rachitpatel019/riscv-cpu/8_stage_pipeline/docs/architecture.html

# 8-Stage Pipelined RISC-V (RV32I) CPU - Architecture Specification

Rendered Web Version: https://htmlpreview.github.io/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
ISA: RISC-V RV32I (Base Integer Instruction Set)
Data Width: 32-bit
Pipeline Depth: 8 stages
Memory: Harvard architecture (separate instruction and data memories)
FPGA Target: Intel/Altera (M9K BRAM inference)
Features: Data forwarding, hazard detection with stalling, branch target early calculation (Stage 4), Branch History Table (BHT) dynamic prediction, branch/jump resolution, MMIO peripherals
Top Module: core

### Table of Contents

1. Architecture Overview
  - Signal Naming Conventions
2. Pipeline Diagram
  - Pipeline Timing Diagram
  - Top-Level Datapath and Diagrams
3. Packages
  - Full ISA Instruction Tables
4. Stage 1 - Fetch (F)
5. Stage 2 - Instruction Memory (IM)
6. Stage 3 - Decode (D)
7. Stage 4 - Register Read (RR)
  - Register File Organization & Replicated BRAMs
8. Stage 5 - Execute 1 (EX1)
9. Stage 6 - Execute 2 (EX2)
10. Stage 7 - Execute 3 / Memory (EX3/MEM)
11. Stage 8 - Writeback (WB)
12. Hazard Detection and Stalling
  - Hazard Detection Flowchart
13. Data Forwarding
14. Branch and Jump Handling
15. Branch History Table (BHT)
  - Branch Predictor State Diagram
16. Memory System
17. Memory-Mapped I/O (MMIO)
18. Pipeline Register Summary
19. Control Signal Reference
20. Module Hierarchy
  - Module Dependency Graph
21. Timing and Performance
22. Corner Cases and Assumptions
23. Glossary of FPGA Terminology

## 1. Architecture Overview

This is an 8-stage pipelined RISC-V processor implementing the RV32I base integer instruction set. The pipeline splits a classic 5-stage design into 8 stages to improve clock frequency on FPGA targets by reducing the critical path length per stage. The stages are:

1. Fetch (F) - PC generation and update; PC redirected by Stage 4 branch prediction or Stage 7 branch/jump resolution
2. Instruction Memory (IM) - Synchronous instruction memory read (1-cycle latency)
3. Decode (D) - Instruction decoding, control signal generation, immediate extraction, and BHT read index generation
4. Register Read (RR) - Register file read (synchronous, 1-cycle latency), forwarding decision, early branch target address calculation (PC + imm), and BHT branch prediction evaluation
5. Execute 1 (EX1) - Operand selection with forwarding muxes
6. Execute 2 (EX2) - ALU computation, branch condition evaluation
7. Execute 3 / Memory (EX3/MEM) - PC target finalization, BHT update, memory read/write initiation
8. Writeback (WB) - Writeback data selection and register file write

The processor uses a Harvard memory architecture with separate instruction and data memories. Both memories are synchronous (M9K BRAM-based), introducing one-cycle read latency each. Data hazards are resolved through a combination of stalling (hazard detection unit) and data forwarding (forwarding unit). Branch target addresses are computed early in Stage 4 (RR) using the decoded PC and immediate, eliminating the one-cycle adder from Stage 6's critical path. A Branch History Table (BHT) provides dynamic taken/not-taken prediction. The BHT is queried in Decode (Stage 3) and evaluated in Register Read (Stage 4). When a branch is predicted taken, it redirects the PC from Stage 4 (RR), reducing the taken-branch penalty from 6 cycles to 3 cycles when the prediction is correct. Unconditional JAL jumps are also resolved early in Stage 4 (RR), incurring a 3-cycle flush penalty. Final branch and JALR jump resolution occurs in Stage 7 (EX3/MEM); a branch misprediction or JALR jump incurs a 6-cycle flush penalty.

### 1.1 Signal Naming Conventions

The codebase employs strict signal naming prefixes to reflect the pipeline stage in which a signal originates or is consumed. This prevents synthesis errors and makes tracing cross-stage paths straightforward.

Prefix | Pipeline Stage | Description / Examples
F_ | Fetch (Stage 1) | Signals active in the Instruction Fetch stage. e.g., F_pc
IM_ | IMEM Read (Stage 2) | Signals active in the Instruction Memory read stage. e.g., IM_instruction
D_ | Decode (Stage 3) | Signals decoded from the instruction. e.g., D_rs1, D_alu_op
IDRR_ / RR_ | Register Read (Stage 4) | Signals related to register read and early branch target evaluation. e.g., IDRR_rs1_data, RR_branch_target
E1_ / EX1_ | Execute 1 (Stage 5) | Signals active during operand selection and forwarding. e.g., E1_operand_a
E2_ / EX2_ | Execute 2 (Stage 6) | Signals active during ALU calculation and branch evaluation. e.g., E2_alu_result
E3_ / EX3_ / MEM_ | EX3 / Memory (Stage 7) | Signals active during memory routing and final PC resolution. e.g., E3_pc_target, E3_pc_sel
W_ / WB_ | Writeback (Stage 8) | Signals written to the register file. e.g., W_write_data, W_reg_write

## 2. Pipeline Diagram

stall_frontend flush (stage4_flush / E3_pc_sel) | | +--------+ +--------+ +--------+ +--------+ +--------+ +--------+ +--------+ +--------+ | Stage 1| | Stage 2| | Stage 3| | Stage 4| | Stage 5| | Stage 6| | Stage 7| | Stage 8| | FETCH |->| IMEM |->| DECODE |->|REG READ|->| EX1 |->| EX2 |->|EX3/MEM |->| WB | | | | | | | | | | | | | | | | | |pc_update| |instr_mem| |IF_ID | |regfile | |data_sel| |alu | |pc_tgt | |write- | | | | | |decode | |fwd_unit| | | |br_eval | |memory | |back | | | | | |imm_gen | |br_tgt | | | |(cond) | |MEM_WB | | | | | | | |control | |ID_RR | | | | | |bht_upd | | | | | | | |bht_read| |bht_pred| | | | | | | | | | | | | | | |RR_EX1 | |EX1_EX2 | |EX2_EX3 | | | | | +--------+ +--------+ +--------+ +--------+ +--------+ +--------+ +--------+ +--------+ |<---------- bht_counter ----------------------+ | | +<------------------------------------------- stage4_pc_sel (from RR) -+ |<---------------------------------------------------------------------+| | E3_pc_sel, E3_pc_target (from Stage 7 JALR / Misprediction) | bht_update (branch, outcome, PC) from Stage 7 to BHT (Stage 4) | | Forwarding Paths: | E2_fwd_val (EX2 -> EX1 data_sel) = (wb_sel==10) ? PC+4 : alu_result | E3_fwd_val (EX3 -> EX1 data_sel) = (wb_sel==10) ? PC+4 : alu_result | W_fwd_val (WB -> EX1 data_sel) = W_write_data | +<------------------------------- W_rd, W_write_data, W_reg_write -------------------+ (Register File Write Port) Hazard Detection Unit: Inputs from: D (rs1, rs2, uses_rs1, uses_rs2), RR (rd, reg_write), E1 (rd, reg_write) Output: stall_frontend -> stalls Stages 1-3, inserts bubble at ID_RR boundary Branch Target Calculation (Stage 4 - RR): branch_target = RR_pc + RR_imm (combinational adder in core.sv) Pipelined through RR_EX1 and EX1_EX2; used by pc_target_calc in Stage 7 and early JAL in Stage 4.

### 2.2 Pipeline Timing Diagram

The following table illustrates the progression of consecutive instructions through all 8 stages of the pipeline over sequential clock cycles.

Instruction | Cycle 1 | Cycle 2 | Cycle 3 | Cycle 4 | Cycle 5 | Cycle 6 | Cycle 7 | Cycle 8 | Cycle 9 | Cycle 10
Inst 1: ADD x1, x2, x3 | F | IM | D | RR | E1 | E2 | E3 | WB
Inst 2: SUB x4, x5, x6 | | F | IM | D | RR | E1 | E2 | E3 | WB
Inst 3: LW x7, 0(x1) | | | F | IM | D | RR | E1 | E2 | E3 | WB
Inst 4: OR x8, x7, x9 (RAW Stall) | | | | F | IM | D | STALL | RR | E1 | E2

## 2.5 Top-Level Datapath and Diagrams

This section contains the block diagrams of the CPU architecture and the detailed datapath interconnects.

### 2.5.1 Top-Level Block Diagram

The diagram below shows the high-level progression of instruction flow and the primary control links.

graph LR F[Stage 1: Fetch] --> IM[Stage 2: IMEM Read] IM --> D[Stage 3: Decode] D --> RR[Stage 4: Reg Read] RR --> E1[Stage 5: Execute 1] E1 --> E2[Stage 6: Execute 2] E2 --> E3[Stage 7: EX3/MEM] E3 --> WB[Stage 8: Writeback] WB -.->|Register Writeback| RR E3 -.->|Branch/Jump Redirect| F RR -.->|Predict Taken Redirect| F

### 2.5.2 Datapath Diagram

A detailed view of the functional units and stage boundaries, highlighting the control signals, multiplexers, and hardware blocks.

graph TD subgraph ST1 [Stage 1: Fetch] PC[PC Register] --> IMEM_ADDR[Instruction Memory Address] end subgraph ST2 [Stage 2: IMEM] IMEM[Instruction Memory] --> INSTR[Instruction Latch] end subgraph ST3 [Stage 3: Decode] DEC[Decode Logic] --> RS1_ADDR[rs1] DEC --> RS2_ADDR[rs2] DEC --> IMM[Immediate Generator] DEC --> CTRL[Control Unit] end subgraph ST4 [Stage 4: Reg Read] RF[Register File Replicated BRAMs] BHT[Branch History Table] ADD_TGT[Early Target Adder: PC + Imm] end subgraph ST5 [Stage 5: EX1] MUX_A[Operand A Mux] MUX_B[Operand B Mux] end subgraph ST6 [Stage 6: EX2] ALU[ALU Unit] BEV[Branch Eval Unit] end subgraph ST7 [Stage 7: EX3/MEM] DMEM[Data Memory BRAM] MMIO[MMIO Router] PTG[PC Target Calc] end subgraph ST8 [Stage 8: WB] MUX_WB[Writeback Mux] end INSTR --> DEC RS1_ADDR & RS2_ADDR --> RF RF --> MUX_A & MUX_B MUX_A & MUX_B --> ALU ALU --> DMEM & MMIO & MUX_WB DMEM & MMIO --> MUX_WB MUX_WB -->|Writeback Data| RF HU[Hazard Detection Unit] -.->|Stall Frontend / Flush ID_RR| PC HU -.->|Stall Frontend / Flush ID_RR| INSTR FU[Forwarding Unit] -.->|EX2/EX3/WB Bypass Selects| MUX_A & MUX_B

## 3. Packages

### 3.1 alu_package (alu_pkg.sv)

Defines the ALU operation encoding as a 4-bit enumerated type alu_operations.

Operation | Encoding | Description
ALU_ADD | 4'b0000 | Addition (A + B)
ALU_SUB | 4'b0001 | Subtraction (A - B)
ALU_AND | 4'b0010 | Bitwise AND
ALU_OR | 4'b0011 | Bitwise OR
ALU_XOR | 4'b0100 | Bitwise XOR
ALU_SLTU | 4'b0101 | Set Less Than Unsigned
ALU_SLT | 4'b0110 | Set Less Than Signed
ALU_SLL | 4'b0111 | Shift Left Logical
ALU_SRL | 4'b1000 | Shift Right Logical
ALU_SRA | 4'b1001 | Shift Right Arithmetic
ALU_PASS | 4'b1010 | Pass-through B (used for LUI)

### 3.2 decoder_package (decoder_pkg.sv)

Defines opcode and function field enumerations for instruction decoding.

#### Opcodes (opcode_t, 7-bit)

Name | Encoding | Instruction Type
OP_R | 7'b0110011 | R-type (register-register ALU)
OP_I | 7'b0010011 | I-type (register-immediate ALU)
OP_I_LOAD | 7'b0000011 | I-type (loads: LB, LH, LW, LBU, LHU)
OP_S | 7'b0100011 | S-type (stores: SB, SH, SW)
OP_B | 7'b1100011 | B-type (conditional branches)
OP_U_LUI | 7'b0110111 | U-type (Load Upper Immediate)
OP_U_AUIPC | 7'b0010111 | U-type (Add Upper Immediate to PC)
OP_J | 7'b1101111 | J-type (JAL)
OP_I_JALR | 7'b1100111 | I-type (JALR)

#### funct3 for R/I-type ALU (f3_RI_t, 3-bit)

Name | Encoding | Operation
F3_ADD_SUB | 3'b000 | ADD / SUB (distinguished by funct7)
F3_SLL | 3'b001 | Shift Left Logical
F3_SLT | 3'b010 | Set Less Than
F3_SLTU | 3'b011 | Set Less Than Unsigned
F3_XOR | 3'b100 | XOR
F3_SRL_SRA | 3'b101 | SRL / SRA (distinguished by funct7)
F3_OR | 3'b110 | OR
F3_AND | 3'b111 | AND

#### funct7 for R-type (f7_R_t, 7-bit)

Name | Encoding | Usage
F7_ADD_SRL | 7'b0000000 | Selects ADD (with F3_ADD_SUB) or SRL (with F3_SRL_SRA)
F7_SUB_SRA | 7'b0100000 | Selects SUB (with F3_ADD_SUB) or SRA (with F3_SRL_SRA)

### 3.3 Full ISA Instruction Tables

The processor implements the standard 32-bit RV32I base user-level ISA. The table below lists all supported instructions, their formats, and functional descriptions.

Instruction | Type | Opcode (7-bit) | funct3 (3-bit) | funct7 (7-bit) | Description
ADD rd, rs1, rs2 | R | 0110011 | 000 | 0000000 | rd = rs1 + rs2
SUB rd, rs1, rs2 | R | 0110011 | 000 | 0100000 | rd = rs1 - rs2
SLL rd, rs1, rs2 | R | 0110011 | 001 | 0000000 | rd = rs1 << rs2[4:0] (logical)
SLT rd, rs1, rs2 | R | 0110011 | 010 | 0000000 | rd = (rs1 < rs2) ? 1 : 0 (signed)
SLTU rd, rs1, rs2 | R | 0110011 | 011 | 0000000 | rd = (rs1 < rs2) ? 1 : 0 (unsigned)
XOR rd, rs1, rs2 | R | 0110011 | 100 | 0000000 | rd = rs1 ^ rs2
SRL rd, rs1, rs2 | R | 0110011 | 101 | 0000000 | rd = rs1 >> rs2[4:0] (logical)
SRA rd, rs1, rs2 | R | 0110011 | 101 | 0100000 | rd = rs1 >> rs2[4:0] (arithmetic)
OR rd, rs1, rs2 | R | 0110011 | 110 | 0000000 | rd = rs1 | rs2
AND rd, rs1, rs2 | R | 0110011 | 111 | 0000000 | rd = rs1 & rs2
ADDI rd, rs1, imm | I | 0010011 | 000 | - | rd = rs1 + imm
SLTI rd, rs1, imm | I | 0010011 | 010 | - | rd = (rs1 < imm) ? 1 : 0 (signed)
SLTIU rd, rs1, imm | I | 0010011 | 011 | - | rd = (rs1 < imm) ? 1 : 0 (unsigned)
XORI rd, rs1, imm | I | 0010011 | 100 | - | rd = rs1 ^ imm
ORI rd, rs1, imm | I | 0010011 | 110 | - | rd = rs1 | imm
ANDI rd, rs1, imm | I | 0010011 | 111 | - | rd = rs1 & imm
SLLI rd, rs1, shamt | I | 0010011 | 001 | 0000000 | rd = rs1 << shamt
SRLI rd, rs1, shamt | I | 0010011 | 101 | 0000000 | rd = rs1 >> shamt (logical)
SRAI rd, rs1, shamt | I | 0010011 | 101 | 0100000 | rd = rs1 >> shamt (arithmetic)
LW rd, offset(rs1) | I | 0000011 | 010 | - | rd = M[rs1 + offset] (32 bits)
LH rd, offset(rs1) | I | 0000011 | 001 | - | rd = M[rs1 + offset] (16 bits, signed)
LHU rd, offset(rs1) | I | 0000011 | 101 | - | rd = M[rs1 + offset] (16 bits, unsigned)
LB rd, offset(rs1) | I | 0000011 | 000 | - | rd = M[rs1 + offset] (8 bits, signed)
LBU rd, offset(rs1) | I | 0000011 | 100 | - | rd = M[rs1 + offset] (8 bits, unsigned)
SW rs2, offset(rs1) | S | 0100011 | 010 | - | M[rs1 + offset] = rs2 (32 bits)
SH rs2, offset(rs1) | S | 0100011 | 001 | - | M[rs1 + offset] = rs2[15:0] (16 bits)
SB rs2, offset(rs1) | S | 0100011 | 000 | - | M[rs1 + offset] = rs2[7:0] (8 bits)
BEQ rs1, rs2, offset | B | 1100011 | 000 | - | if (rs1 == rs2) PC = PC + offset
BNE rs1, rs2, offset | B | 1100011 | 001 | - | if (rs1 != rs2) PC = PC + offset
BLT rs1, rs2, offset | B | 1100011 | 100 | - | if (rs1 < rs2) PC = PC + offset (signed)
BGE rs1, rs2, offset | B | 1100011 | 101 | - | if (rs1 >= rs2) PC = PC + offset (signed)
BLTU rs1, rs2, offset | B | 1100011 | 110 | - | if (rs1 < rs2) PC = PC + offset (unsigned)
BGEU rs1, rs2, offset | B | 1100011 | 111 | - | if (rs1 >= rs2) PC = PC + offset (unsigned)
LUI rd, imm | U | 0110111 | - | - | rd = imm << 12
AUIPC rd, imm | U | 0010111 | - | - | rd = PC + (imm << 12)
JAL rd, offset | J | 1101111 | - | - | rd = PC + 4; PC = PC + offset
JALR rd, offset(rs1) | I | 1100111 | 000 | - | rd = PC + 4; PC = (rs1 + offset) & ~1

## 4. Stage 1 - Fetch (F)

### Module: pc_update

File: rtl/core/1_fetch/pc_update.sv

Generates the program counter. On each rising clock edge, updates PC based on priority:

1. reset - PC resets to 32'b0
2. pc_sel (branch/jump taken) - PC loads pc_target from Stage 7
3. stall (hazard detected) - PC holds its current value
4. Default - PC increments by 4 (pc + 4)

#### Port Interface

Port | Direction | Width | Description
clk | input | 1 | System clock
reset | input | 1 | Synchronous reset
stall | input | 1 | From hazard detection unit (stall_frontend)
pc_sel | input | 1 | Branch/jump taken signal from Stage 7 (E3_pc_sel)
pc_target | input | 32 | Target PC from Stage 7 (E3_pc_target)
pc | output | 32 | Current program counter (F_pc)

## 5. Stage 2 - Instruction Memory (IM)

### Module: instr_mem

File: rtl/core/2_imem/instr_mem.sv

Synchronous instruction memory modeled as a 16384-entry ROM/RAM array, initialized from program.hex via $readmemh. Uses M9K BRAM inference on Intel/Altera FPGAs. The synchronous read introduces a 1-cycle latency, justifying a dedicated pipeline stage.

Design Rationale — Inferring BRAM for ROM and RAM Blocks
Standard FPGA logic cells (LEs) are built to implement logic gates and individual registers, not bulk memory arrays. Registering 64 KB of Instruction ROM and 64 KB of Data RAM using Logic Elements would completely exhaust the target device resources and cause severe place-and-route congestion. Instead, this design structures ROM and RAM modules to infer physical block RAM (M9K blocks). This maps memory accesses directly onto high-speed dedicated static memory blocks on the silicon, leaving general logic elements free for the CPU execution pipeline control logic.

#### Behavior

- On each clock edge (when not stalled): reads instruction_memory[pc[31:2]] into instr_reg and latches pc into pc_reg.
- A flush_reg flag is set on reset or flush, and cleared on the next non-stalled cycle.
- When flush_reg is active, the output instruction is replaced with NOP (32'h00000013, which is ADDI x0, x0, 0) and pc_out is zeroed.

#### Port Interface

Port | Direction | Width | Description
clk | input | 1 | System clock
reset | input | 1 | Synchronous reset
stall | input | 1 | Stall signal (stall_frontend)
flush | input | 1 | Flush signal (E3_pc_sel)
pc | input | 32 | Program counter from Stage 1 (F_pc)
pc_out | output | 32 | Registered PC (IM_pc_out)
instruction | output | 32 | Fetched instruction (IM_instruction)

#### Memory Parameters

Parameter | Value | Description
MEM_DEPTH | 16384 | Number of 32-bit instruction words (64 KiB)

## 6. Stage 3 - Decode (D)

Stage 3 contains the IF/ID pipeline register, the decode unit (which wraps the immediate generator and control unit), and the ID/RR pipeline register at the stage boundary.

### 6.1 Module: IF_ID (Pipeline Register)

File: rtl/core/3_decode/IF_ID.sv

Pipeline register between Stages 2 (IMEM) and 3 (Decode). Holds the instruction and PC. On reset or flush, inserts a NOP (32'h00000013) and zeros the PC. On stall, holds its current values.

#### Port Interface

Port | Direction | Width | Description
clk | input | 1 | System clock
reset | input | 1 | Synchronous reset
stall | input | 1 | Stall signal (stall_frontend)
flush | input | 1 | Flush signal (E3_pc_sel)
pc_in | input | 32 | PC from IMEM stage (IM_pc_out)
instruction_in | input | 32 | Instruction from IMEM (IM_instruction)
pc_out | output | 32 | Registered PC (D_pc)
instruction_out | output | 32 | Registered instruction (D_instruction)

### 6.2 Module: decode (Decode Unit)

File: rtl/core/3_decode/decode.sv

Top-level decode wrapper. Extracts rs1 (bits [19:15]), rs2 (bits [24:20]), and rd (bits [11:7]) from the instruction. Instantiates imm_gen and control as sub-modules. All outputs are purely combinational.

#### Port Interface

Port | Direction | Width | Description
pc | input | 32 | Program counter (D_pc)
instruction | input | 32 | 32-bit instruction (D_instruction)
immediate | output | 32 | Sign-extended immediate value
rs1 | output | 5 | Source register 1 address
rs2 | output | 5 | Source register 2 address
rd | output | 5 | Destination register address
pc_out | output | 32 | PC pass-through
uses_rs1 | output | 1 | Instruction reads rs1
uses_rs2 | output | 1 | Instruction reads rs2
alu_op | output | 4 | ALU operation select
alu_src_a | output | 1 | 0=rs1, 1=PC for ALU input A
alu_src_b | output | 1 | 0=rs2, 1=immediate for ALU input B
reg_write | output | 1 | Register write enable
mem_read | output | 1 | Memory read enable
mem_write | output | 1 | Memory write enable
mem_size | output | 2 | Memory access size: 00=byte, 01=halfword, 10=word
mem_unsigned | output | 1 | Unsigned memory load flag
wb_sel | output | 2 | Writeback source: 00=ALU, 01=memory, 10=PC+4
branch | output | 1 | Branch instruction flag
jump | output | 1 | Jump instruction flag (JAL/JALR)
branch_type | output | 3 | Branch condition type (funct3 encoding)

### 6.3 Module: imm_gen (Immediate Generator)

File: rtl/core/3_decode/imm_gen.sv

Generates sign-extended 32-bit immediate values based on the RISC-V instruction format. Selection is determined by the opcode field.

Format | Opcodes | Immediate Construction
I-type | OP_I, OP_I_LOAD, OP_I_JALR | {{20{inst[31]}}, inst[31:20]}
S-type | OP_S | {{20{inst[31]}}, inst[31:25], inst[11:7]}
B-type | OP_B | {{19{inst[31]}}, inst[31], inst[7], inst[30:25], inst[11:8], 1'b0}
U-type | OP_U_LUI, OP_U_AUIPC | {inst[31:12], 12'b0}
J-type | OP_J | {{11{inst[31]}}, inst[31], inst[19:12], inst[20], inst[30:21], 1'b0}

### 6.4 Module: control (Control Unit)

File: rtl/core/3_decode/control.sv

Decodes the instruction opcode, funct3, and funct7 fields to produce all control signals. Combinational logic only. Imports both decoder_package and alu_package.

#### Control Signal Generation by Instruction Type

Instruction | uses_rs1 | uses_rs2 | alu_src_a | alu_src_b | reg_write | mem_read | mem_write | wb_sel | branch | jump
R-type | 1 | 1 | 0 | 0 | 1 | 0 | 0 | 00 | 0 | 0
I-type ALU | 1 | 0 | 0 | 1 | 1 | 0 | 0 | 00 | 0 | 0
Load | 1 | 0 | 0 | 1 | 1 | 1 | 0 | 01 | 0 | 0
Store | 1 | 1 | 0 | 1 | 0 | 0 | 1 | 00 | 0 | 0
Branch | 1 | 1 | 0 | 0 | 0 | 0 | 0 | 00 | 1 | 0
LUI | 0 | 0 | 0 | 1 | 1 | 0 | 0 | 00 | 0 | 0
AUIPC | 0 | 0 | 1 | 1 | 1 | 0 | 0 | 00 | 0 | 0
JAL | 0 | 0 | 1 | 1 | 1 | 0 | 0 | 10 | 0 | 1
JALR | 1 | 0 | 0 | 1 | 1 | 0 | 0 | 10 | 0 | 1

Note: mem_size is assigned directly from funct3[1:0], mem_unsigned from funct3[2], and branch_type from funct3. These are valid for load, store, and branch instructions respectively; for other instruction types they are don't-care values because the corresponding enable signals (mem_read, mem_write, branch) are deasserted.

#### ALU Operation Selection

Instruction Type | ALU Operation Logic
R-type | Decoded from funct3 + funct7 to specific ALU op
I-type ALU | Decoded from funct3 (+ funct7 for shifts) to specific ALU op
Load / Store | ALU_ADD (address calculation)
Branch | ALU_SUB (BEQ/BNE), ALU_SLT (BLT/BGE), ALU_SLTU (BLTU/BGEU)
LUI | ALU_PASS (pass immediate through)
AUIPC | ALU_ADD (PC + immediate)
JAL / JALR | ALU_ADD (target address calculation)

### 6.5 Module: ID_RR (Pipeline Register)

File: rtl/core/3_decode/ID_RR.sv

Pipeline register at the Decode/Register-Read boundary. Registers all decoded data fields and control signals. On reset or flush, all outputs are zeroed (inserting a NOP bubble). On stall, holds current values.

Important: In the core instantiation, ID_RR.flush is driven by flush || stall_frontend. This means that when the frontend is stalled, the ID_RR register is flushed (bubble inserted) rather than held. This prevents a stalled instruction from being duplicated into the backend.

#### Registered Signals

Immediate (32b), rs1 (5b), rs2 (5b), rd (5b), pc (32b), uses_rs1 (1b), uses_rs2 (1b), alu_op (4b), alu_src_a (1b), alu_src_b (1b), reg_write (1b), mem_read (1b), mem_write (1b), mem_size (2b), mem_unsigned (1b), wb_sel (2b), branch (1b), jump (1b), branch_type (3b).

## 7. Stage 4 - Register Read (RR)

Stage 4 reads operands from the register file (synchronous read, 1-cycle latency), computes forwarding select signals for Stage 5, and calculates the branch target address (PC + sign-extended immediate) combinationally from the ID_RR register outputs.

Design Rationale — Why Evaluate Branches in Stage 4?
Evaluating branch predictions in Stage 4 (Register Read) instead of Stage 3 (Decode) is a key timing and penalty optimization. Reading the BHT is initiated in Stage 3, and the resulting prediction is evaluated in Stage 4 where register operands and PC-relative branch target addresses (calculated combinationally in core.sv) are first available. By redirecting the PC from Stage 4 (flushing only stages 1–3), we limit the taken-branch penalty to exactly 3 cycles while keeping the BHT read and target addition paths from bloat-timing the Stage 3 critical path.

### 7.1 Module: regfile (Register File)

File: rtl/core/4_reg_read/regfile.sv

32-entry x 32-bit register file with two synchronous read ports and one synchronous write port. To guarantee dedicated block RAM (BRAM) mapping on the FPGA target (such as Intel M9K blocks) and eliminate LUT-based soft-logic usage, the register file uses two identical replicated RAM arrays: registers_a and registers_b. Each replicated block is configured as a Simple Dual-Port (1R1W) BRAM.

Write operations update both registers_a and registers_b simultaneously to keep the BRAM states synchronized. Read port 1 (rs1) reads from registers_a, and read port 2 (rs2) reads from registers_b. Register x0 is hardwired to zero (writes to x0 are suppressed, and it always reads as zero).

Supports explicit synchronous read-during-write forwarding: if a register is written and read in the same cycle, the write data is forwarded directly to the registered read outputs on the next clock edge, avoiding read collisions within the physical BRAM cells.

### 7.1.1 Register File Organization & Replicated BRAMs

The register file must support two concurrent read ports (rs1, rs2) and one write port (rd) in a single cycle. However, physical block RAM structures on Intel FPGAs (M9K cells) are dual-ported (supporting only 1 Read/1 Write or 2 Read/2 Write under restricted configurations).

To implement 2 Read ports and 1 Write port without using inefficient register logic (LE-based flip-flops), the Register File is designed as Replicated BRAMs:

- Replication: The 32x32 register array is duplicated into two identical physical RAMs: registers_a and registers_b.
- Write Operations: When a writeback instruction commits in Stage 8, both registers_a and registers_b are written simultaneously at the same write_address with the same write_data. This keeps their contents completely identical.
- Read Operations: Read port 1 (rs1) reads from registers_a, and Read port 2 (rs2) reads from registers_b. Since they access independent RAM blocks, both reads execute simultaneously in a single cycle.
- Collision Handling: Read-during-write conflicts (accessing a register being written in the same clock cycle) are resolved by local forwarding logic inside the regfile module. If the read index matches the write index, the write data is returned directly instead of waiting for the internal BRAM array update.

#### Port Interface

Port | Direction | Width | Description
clk | input | 1 | System clock
read_address1 | input | 5 | Read port 1 address (IDRR_rs1)
read_address2 | input | 5 | Read port 2 address (IDRR_rs2)
read_data1 | output | 32 | Read port 1 data (E1_rs1_data)
read_data2 | output | 32 | Read port 2 data (E1_rs2_data)
write_address | input | 5 | Write port address (W_rd)
write_data | input | 32 | Write port data (W_write_data)
write_enable | input | 1 | Write enable (W_reg_write)

Note: The register file uses synchronous reads (clocked), which means the read data appears one cycle after the address is presented. This is why the register file read occupies its own pipeline stage (Stage 4). The read addresses come from the ID_RR register (end of Stage 3), and the read data emerges at the input to Stage 5 (EX1), preserving the 8-stage pipeline.

### 7.2 Module: forwarding_unit

File: rtl/core/hazard_control/forwarding_unit.sv

Computed in Stage 4 (using ID_RR outputs) but the select signals are consumed in Stage 5 (via RR_EX1 register). See Section 13: Data Forwarding for full details.

### 7.3 Module: branch_predictor (Branch Predictor & Target Calculation)

File: rtl/core/4_reg_read/branch_predictor.sv

Encapsulates dynamic branch prediction and early branch target address calculation in Stage 4 (Register Read). The module instantiates the 1024-entry bht block RAM internally and provides:

- Early Branch Target Calculation: Combinationally adds PC and immediate (IDRR_branch_target = IDRR_pc + IDRR_immediate), removing the branch adder from Stage 6's critical path.
- Direction Prediction: Evaluates the registered 2-bit counter value from the BHT and asserts IDRR_predict_taken when the MSB is high (IDRR_branch && IDRR_counter_val[1]).
- Next Counter Computation: Combinationally computes the updated 2-bit saturating counter value (E3_next_counter) based on Stage 7 execution outcome (E3_condition_met) to update the BHT upon branch resolution.

#### Port Interface

Port | Direction | Width | Source / Destination | Description
clk | input | 1 | System clock | Clock source for BHT RAM
reset | input | 1 | System reset | Initializes BHT counters to weakly not-taken (2'b01)
D_pc | input | 32 | Stage 3 (Decode) | PC used to index BHT read port (bits [11:2])
stall_frontend | input | 1 | Pipeline Control Unit | Disables BHT read when frontend pipeline is stalled
IDRR_pc | input | 32 | ID_RR register | Stage 4 PC for target calculation
IDRR_immediate | input | 32 | ID_RR register | Stage 4 branch offset immediate
IDRR_branch | input | 1 | ID_RR register | Branch instruction indicator in Stage 4
E3_pc | input | 32 | EX2_EX3 register | Stage 7 PC used to index BHT write port (bits [11:2])
E3_branch | input | 1 | EX2_EX3 register | Write enable for BHT update in Stage 7
E3_counter_val | input | 2 | EX2_EX3 register | Original counter value registered from Stage 4
E3_condition_met | input | 1 | Stage 6 (branch_eval) | Actual branch evaluation outcome from Stage 6/7
IDRR_branch_target | output | 32 | RR_EX1 / pc_update | Calculated target address for branch
IDRR_predict_taken | output | 1 | pipeline_control_unit | Prediction outcome for early PC redirection
IDRR_counter_val | output | 2 | RR_EX1 | Counter value read from BHT for pipelining to Stage 7
E3_next_counter | output | 2 | Internal BHT write port | Updated counter value written into BHT

Scope: This calculation computes the B-type and J-type (JAL) PC-relative target only. JALR targets depend on a register value (rs1 + imm), which is not available until EX1; the JALR target continues to be computed by the ALU in Stage 6 and finalized by pc_target_calc in Stage 7.

### 7.4 Module: RR_EX1 (Pipeline Register)

File: rtl/core/4_reg_read/RR_EX1.sv

Pipeline register at the Register-Read/EX1 boundary. Registers all data, control, forwarding select signals, and the early-computed branch target. On reset or flush, all outputs are zeroed. No stall input (this register is never stalled; only the frontend stages 1-3 stall).

#### Registered Signals

All signals from ID_RR, plus: forward_a_sel (2b), forward_b_sel (2b), and branch_target (32b, computed combinational in Stage 4).

## 8. Stage 5 - Execute 1 (EX1)

Stage 5 applies forwarding muxes to select the correct operand values before the ALU.

### 8.1 Module: data_sel (Operand Selection Unit)

File: rtl/core/5_ex1/data_sel.sv

Multiplexes between register file data, forwarded data from downstream stages, PC, and immediate values to produce the final ALU operands.

#### Operand A Selection

1. forward_a_sel selects the base rs1 value:
  - 2'b00: rs1_data (from register file)
  - 2'b01: fwd_ex2_data (forwarded from EX2/EX3 boundary = E3_fwd_val)
  - 2'b10: fwd_ex3_data (forwarded from EX3/WB boundary = W_fwd_val)
2. alu_src_a selects between rs1_final (0) and pc (1).

#### Operand B Selection

1. forward_b_sel selects the base rs2 value (same encoding as above).
2. alu_src_b selects between rs2_final (0) and imm (1).

Additionally, rs2_data_out outputs the forwarded rs2 value (before the alu_src_b mux), which is used as store data for memory write instructions.

#### Forwarding Value Sources (defined in core.sv)

Signal | Source | Value
E2_fwd_val | Connected to fwd_ex2_data via E3_fwd_val | (E2_wb_sel == 2'b10) ? E2_pc + 4 : E2_alu_result
E3_fwd_val | Connected to fwd_ex2_data input | (E3_wb_sel == 2'b10) ? E3_pc + 4 : E3_alu_result
W_fwd_val | Connected to fwd_ex3_data input | W_write_data

Important wiring detail: In core.sv, data_sel.fwd_ex2_data is connected to E3_fwd_val (not E2_fwd_val), and data_sel.fwd_ex3_data is connected to W_fwd_val. The third input fwd_wb_data is tied to 32'b0 and is currently unused. The forwarding select encoding from the forwarding unit (2'b01 = EX2 stage result, 2'b10 = EX3 stage result) maps to these physical connections.

### 8.2 Module: EX1_EX2 (Pipeline Register)

File: rtl/core/5_ex1/EX1_EX2.sv

Pipeline register at the EX1/EX2 boundary. Registers selected operands, ALU control, branch/jump signals, memory control, and writeback signals. On reset or flush, all outputs are zeroed.

#### Registered Signals

PC (32b), alu_op (4b), imm (32b), branch (1b), jump (1b), branch_type (3b), reg_write (1b), rd (5b), operand_a (32b), operand_b (32b), rs2_data (32b), mem_read (1b), mem_write (1b), mem_size (2b), mem_unsigned (1b), wb_sel (2b).

## 9. Stage 6 - Execute 2 (EX2)

Stage 6 performs the main ALU computation and evaluates branch conditions. Branch target calculation has been moved to Stage 4; the pre-computed target arrives via the EX1_EX2 pipeline register and is passed through to Stage 7 without recomputation.

Design Rationale - Splitting the Execute Logic into 3 Stages
In standard 5-stage pipelines, the Execute stage is the primary critical path because it performs operand forwarding multiplexing, ALU calculations, and branch target resolution in a single clock cycle. To maximize clock frequency on the MAX 10 FPGA, this design divides these operations across three pipelined stages: operand selection (EX1), ALU computation (EX2), and branch resolution/memory routing (EX3). This split successfully increased the operating clock frequency to 125.00 MHz.

### 9.1 Module: alu (Arithmetic Logic Unit)

File: rtl/core/6_ex2/alu.sv

Purely combinational ALU. All operations are computed in parallel; the control input selects which result to output.

#### Port Interface

Port | Direction | Width | Description
A | input | 32 | Operand A (E2_operand_a)
B | input | 32 | Operand B (E2_operand_b)
control | input | 4 | ALU operation select (E2_alu_op)
result | output | 32 | ALU result (E2_alu_result)

#### Operations

ADD, SUB, AND, OR, XOR are straightforward 32-bit operations. Shifts (SLL, SRL, SRA) use only B[4:0] as the shift amount. SLT and SLTU produce a 32-bit result with the comparison result in bit 0 and zeros in bits [31:1]. ALU_PASS outputs B directly (used for LUI).

### 9.2 Module: branch_eval (Branch Condition Evaluation Unit)

File: rtl/core/6_ex2/branch_eval.sv

Evaluates branch conditions only. Purely combinational. The branch target address is no longer computed here; it arrives pre-computed from Stage 4 via the EX1_EX2 pipeline register (E2_branch_target).

#### Port Interface

Port | Direction | Width | Description
operand_a | input | 32 | Source operand A (E2_operand_a)
operand_b | input | 32 | Source operand B (E2_operand_b)
branch_type | input | 3 | Branch condition type (funct3)
condition_met | output | 1 | Branch condition result (E2_condition_met)

#### Branch Condition Evaluation

branch_type | RISC-V Mnemonic | Condition
3'b000 | BEQ | operand_a == operand_b
3'b001 | BNE | operand_a != operand_b
3'b100 | BLT | $signed(operand_a) < $signed(operand_b)
3'b101 | BGE | $signed(operand_a) >= $signed(operand_b)
3'b110 | BLTU | operand_a < operand_b
3'b111 | BGEU | operand_a >= operand_b

Note: The branch condition evaluation in branch_eval operates on the raw operand values (operand_a and operand_b), which are the same values fed to the ALU. For branch instructions, alu_src_a=0 and alu_src_b=0, so these are the (possibly forwarded) register values. The pre-computed branch target (E2_branch_target) is passed through from the pipeline register unchanged.

### 9.3 Module: EX2_EX3 (Pipeline Register)

File: rtl/core/6_ex2/EX2_EX3.sv

Pipeline register at the EX2/EX3 boundary. Registers ALU result, branch condition result, pre-computed branch target (originally from Stage 4), memory control, and writeback signals. On reset or flush, all outputs are zeroed.

#### Registered Signals

PC (32b), imm (32b), branch (1b), jump (1b), branch_type (3b), reg_write (1b), rd (5b), operand_a (32b), operand_b (32b), rs2_data (32b), alu_result (32b), condition_met (1b), branch_target (32b, pipelined from Stage 4), mem_read (1b), mem_write (1b), mem_size (2b), mem_unsigned (1b), wb_sel (2b).

## 10. Stage 7 - Execute 3 / Memory (EX3/MEM)

Stage 7 performs three operations: PC target finalization for branches/jumps, memory access initiation, and preparation of the writeback intermediate value. This is the stage where branch/jump resolution occurs, generating the flush signal.

### 10.1 Module: pc_target_calc (PC Target Calculator)

File: rtl/core/7_ex3_mem/pc_target_calc.sv

Computes the final PC selection signal and target address for branches and jumps.

#### Port Interface

Port | Direction | Width | Description
pc | input | 32 | PC of the instruction (E3_pc)
operand_a | input | 32 | Operand A (unused in current logic)
operand_b | input | 32 | Operand B (unused in current logic)
branch | input | 1 | Branch flag (E3_branch)
jump | input | 1 | Jump flag (E3_jump)
branch_type | input | 3 | Branch type (unused in current logic)
imm | input | 32 | Immediate value (E3_imm)
alu_result | input | 32 | ALU result (E3_alu_result); used as JALR target
condition_met_in | input | 1 | Branch condition result (E3_condition_met)
branch_target_in | input | 32 | Branch target pipelined from Stage 4 (E3_branch_target)
pc_sel | output | 1 | PC redirect signal (E3_pc_sel)
pc_target | output | 32 | Target PC value (E3_pc_target)

#### Behavior

- pc_sel = jump || (branch && condition_met_in)
- If jump: pc_target = alu_result & 32'hFFFFFFFC (4-byte aligned)
- If branch && condition_met: pc_target = branch_target_in & 32'hFFFFFFFC (4-byte aligned)
- Otherwise: pc_target = 32'b0

JAL vs JALR target computation:

- JAL: alu_src_a=1 (PC), alu_src_b=1 (imm). ALU computes PC + imm. pc_target_calc uses alu_result & 0xFFFFFFFC as the jump target.
- JALR: alu_src_a=0 (rs1), alu_src_b=1 (imm). ALU computes rs1 + imm. pc_target_calc uses alu_result & 0xFFFFFFFC as the jump target, clearing the lowest 2 bits per the RISC-V specification.
- Branch: Target is branch_target_in (= PC + imm, computed in branch_eval), also 4-byte aligned.

### 10.2 Module: memory (Memory System Top-Level)

File: rtl/core/7_ex3_mem/memory.sv

Memory interconnect that routes read/write requests to either data memory (BRAM) or MMIO based on the address. See Section 15: Memory System for full details.

### 10.3 Module: fwd_sel (Forwarding Selector & Pre-Writeback Mux)

File: rtl/core/7_ex3_mem/fwd_sel.sv

Pre-writeback operand multiplexer in Stage 7 (EX3/MEM). Selects between link PC (pc_plus_4 for JAL/JALR when wb_sel == 2'b10) and execution ALU result (alu_result) to generate the pre-writeback value fwd_val (E3_fwd_val).

This value is forwarded directly to Stage 5 (EX1) via the data forwarding network (for EX2-to-EX1 forwarding) and is registered into the MEM_WB pipeline register as alu_result_in.

#### Port Interface

Port | Direction | Width | Source / Destination | Description
wb_sel | input | 2 | EX2_EX3 register | Writeback source selector
pc_plus_4 | input | 32 | EX2_EX3 register | Return/link address (PC + 4)
alu_result | input | 32 | EX2_EX3 register | ALU computation result
fwd_val | output | 32 | Stage 5 / MEM_WB | Forwarded value (E3_fwd_val) to data_sel and MEM_WB

### 10.4 Module: MEM_WB (Pipeline Register)

File: rtl/core/7_ex3_mem/MEM_WB.sv

Pipeline register at the MEM/WB boundary. On reset or flush (currently hardwired to 1'b0), all outputs are zeroed.

#### Port Interface

Port | Direction | Width | Description
rd_in/out | I/O | 5 | Destination register
reg_write_in/out | I/O | 1 | Register write enable
alu_result_in/out | I/O | 32 | ALU result or PC+4 (W_wb_intermediate)
mem_read_data_in/out | I/O | 32 | Memory read data (input currently tied to 32'b0)
wb_sel_in/out | I/O | 2 | Writeback source select
pc_in/out | I/O | 32 | PC value

Memory read data registration: The memory read data (W_mem_read_data_raw) is routed through the MEM_WB pipeline register (mem_read_data_in to mem_read_data_out), producing the registered W_mem_read_data output. Because memory read is initiated in Stage 6 (EX2), its output is ready at Stage 7 (EX3/MEM), registered at the MEM/WB boundary, and consumed in Stage 8 (WB) aligned with other writeback inputs.

## 11. Stage 8 - Writeback (WB)

### Module: writeback

File: rtl/core/8_wb/writeback.sv

Combinational writeback multiplexer. Selects the data to write back to the register file.

#### Port Interface

Port | Direction | Width | Description
pc | input | 32 | PC value (W_pc) - currently unused in mux logic
alu_result | input | 32 | ALU result / PC+4 from MEM_WB (W_alu_result)
mem_data | input | 32 | Memory read data (W_mem_read_data)
wb_sel | input | 2 | Writeback select (W_wb_sel)
write_data | output | 32 | Final writeback data (W_write_data)

#### Selection Logic

write_data = (wb_sel[0]) ? mem_data : alu_result

wb_sel | Source | Used By
2'b00 | alu_result | R-type, I-type ALU, LUI, AUIPC
2'b01 | mem_data | Load instructions
2'b10 | alu_result (which holds PC+4) | JAL, JALR (link address)

Note: The mux uses only wb_sel[0], so wb_sel=2'b10 and wb_sel=2'b00 both select alu_result. For JAL/JALR, the alu_result port already contains PC+4 because the W_wb_intermediate computation in core.sv substitutes PC+4 when wb_sel==2'b10.

## 12. Hazard Detection and Stalling

### Module: pipeline_control_unit

File: rtl/core/hazard_control/pipeline_control_unit.sv

Combines load-use hazard stall detection, global pipeline flushes from Stage 7 branch/jump resolution, and Stage 4 early jump/taken branch redirects.

#### Port Interface

Port | Direction | Width | Source / Destination | Description
D_rs1 | input | 5 | Stage 3 decode | Source register 1 of current instruction in decode
D_rs2 | input | 5 | Stage 3 decode | Source register 2 of current instruction in decode
D_uses_rs1 | input | 1 | Stage 3 decode | Current instruction reads rs1
D_uses_rs2 | input | 1 | Stage 3 decode | Current instruction reads rs2
RR_reg_write | input | 1 | ID_RR output | Instruction in RR stage writes a register
RR_mem_read | input | 1 | ID_RR output | Instruction in RR stage reads data memory (load)
RR_rd | input | 5 | ID_RR output | Destination register of RR instruction
E1_reg_write | input | 1 | RR_EX1 output | Instruction in EX1 stage writes a register
E1_mem_read | input | 1 | RR_EX1 output | Instruction in EX1 stage reads data memory (load)
E1_rd | input | 5 | RR_EX1 output | Destination register of EX1 instruction
E3_pc_sel | input | 1 | Stage 7 pc_target_calc | Stage 7 branch misprediction / JALR redirect
IDRR_jump | input | 1 | ID_RR output | Jump flag in Stage 4
IDRR_uses_rs1 | input | 1 | ID_RR output | JALR flag in Stage 4 (uses rs1)
IDRR_predict_taken | input | 1 | Stage 4 branch_predictor | Branch predicted taken in Stage 4
stall | output | 1 | Frontend control | Stall signal (stall_frontend)
flush | output | 1 | Pipeline registers | Global flush signal (flush)
stage4_pc_sel | output | 1 | Stage 1 pc_update | Early PC redirect selector for JAL or predicted-taken branches
stage4_flush | output | 1 | ID_RR register | Early flush signal for Stage 3/4 pipeline boundary

#### Stall Conditions

Only load-use data hazards trigger pipeline stalls. ALU dependencies are resolved without stalling via the forwarding network. A stall is asserted (stall = 1'b1) when either:

1. RR load-use hazard: A load instruction in RR (Stage 4) has RR_rd != x0 and matches a source register read by the Decode (Stage 3) instruction (D_rs1 == RR_rd && D_uses_rs1 or D_rs2 == RR_rd && D_uses_rs2).
2. EX1 load-use hazard: A load instruction in EX1 (Stage 5) has E1_rd != x0 and matches a source register read by the Decode instruction.

#### Flush and Early Redirect Logic

- flush = E3_pc_sel;: Asserts a global pipeline flush on Stage 7 branch mispredictions and JALR jumps.
- IDRR_is_jal = IDRR_jump && !IDRR_uses_rs1;: Identifies early unconditional JAL jumps in Stage 4.
- stage4_pc_sel = IDRR_predict_taken || IDRR_is_jal;: Redirects PC early to target in Stage 4.
- stage4_flush = stage4_pc_sel;: Flushes transient instructions when early redirect fires.

#### Stall Effect

- stall_frontend freezes Stages 1-3: PC holds, IMEM holds, IF_ID holds, and ID_RR is flushed (with NOP bubble).
- Stages 4-8 continue advancing normally during a stall.

### 12.1 Hazard Detection Flowchart

The flowchart below illustrates the decision path for stall generation and pipeline flushes based on instruction dependencies.

graph TD A[Instruction Decoded in Stage 3] --> B{Does it use rs1 or rs2?} B -- No --> H[No Stall Required] B -- Yes --> C{Is producer in RR Stage a Load & rd matches?} C -- Yes --> G[Assert stall_frontend & Flush ID_RR] C -- No --> D{Is producer in EX1 Stage a Load & rd matches?} D -- Yes --> G D -- No --> E{Is producer in EX2, EX3, or WB stage?} E -- Yes --> F[Forward value combinational in EX1] E -- No --> H

## 13. Data Forwarding

### Module: forwarding_unit

File: rtl/core/hazard_control/forwarding_unit.sv

Pre-calculates forwarding select signals in Stage 4 (RR) for use in Stage 5 (EX1). The forwarding unit checks whether downstream pipeline stages have results that can be forwarded to resolve data dependencies without stalling.

#### Forwarding Select Encoding

Select Value | Source | Pipeline Location
2'b00 | Register file output (no forwarding) | Stage 4 output
2'b01 | EX2 stage result | EX2/EX3 boundary (E3_fwd_val)
2'b10 | EX3/WB stage result | WB output (W_fwd_val)

#### Forwarding Conditions (for each of rs1 and rs2)

1. Forward from EX2: E2_reg_write && !E2_mem_read && (E2_rd == IDRR_rsN) && (IDRR_rsN != 0) Forwards non-load ALU results from the EX2 stage.
2. Forward from EX3: E3_reg_write && (E3_rd == IDRR_rsN) && (IDRR_rsN != 0) Forwards any result from the EX3 stage (including load data via W_fwd_val).

Priority: EX2 forwarding (2'b01) has higher priority than EX3 forwarding (2'b10). If both stages have a matching destination register, the more recent result (EX2) is forwarded. Load instructions in EX2 are excluded from forwarding (!E2_mem_read) because their data is not yet available; this triggers a stall via the hazard detection unit instead.

#### Forwarding Path Timing

Cycle N: ... | D(instr_A) | RR | EX1 | EX2(instr_B) | EX3(instr_C) | ... | | fwd_unit | data_sel | | | | | computes | applies | | | | | selects | forwarding| | | Forward from EX2 (2'b01): instr_B's result -> instr_A's operand (2-stage gap: RR to EX2) Forward from EX3 (2'b10): instr_C's result -> instr_A's operand (3-stage gap: RR to EX3) The forwarding select is registered in RR_EX1, so it is stable when data_sel reads it in EX1.

## 14. Branch and Jump Handling

### 14.1 Resolution Point

Unconditional JAL jumps are resolved early in Stage 4 (RR) by the stage4_pc_sel logic using the early branch target calculator. Conditional branches and JALR jumps are resolved in Stage 7 (EX3/MEM) by the pc_target_calc module. The redirect signal (stage4_pc_sel in Stage 4 or E3_pc_sel in Stage 7) triggers a pipeline flush.

### 14.2 Flush Mechanism

When a redirect is asserted:

- For early JAL resolution in Stage 4: the stage4_flush signal flushes Stages 2 and 3 (IMEM and IF_ID).
- For Stage 7 branch/JALR resolution: the flush signal (driven by E3_pc_sel) is broadcast to all pipeline registers from IF_ID through EX2_EX3, clearing all 6 in-flight stages.
- The pc_update module loads the correct target PC on the next clock edge.
- The BHT entry for the resolved branch is updated with the actual outcome.

### 14.3 Branch and Jump Penalty

Unconditional jumps and conditional branches incur the following penalties:

- Unconditional JAL Jump: 3-cycle flush penalty (resolved in Stage 4).
- Unconditional JALR Jump: 6-cycle flush penalty (resolved in Stage 7).
- Conditional Branch (correct prediction): 0 extra cycles (for predicted not-taken) or 3 cycles (for predicted taken, redirected in Stage 4).
- Conditional Branch (misprediction): 6-cycle flush penalty (redirected in Stage 7).

Not-taken branches that are correctly predicted incur no penalty. The BHT reduces the average branch penalty compared to the prior always-predict-not-taken scheme.

### 14.4 Flush Signal Distribution

Module | Flush Input | Source | Description
instr_mem | flush | pipeline_control_unit (flush) | Flushed on Stage 7 branch mispredictions and JALR jumps
IF_ID | flush | pipeline_control_unit (flush) | Flushed on Stage 7 branch mispredictions and JALR jumps
ID_RR | flush | flush || stall_frontend || stage4_flush | Flushed on Stage 7 redirects, load-use stalls, or Stage 4 early redirects
RR_EX1 | flush | pipeline_control_unit (flush) | Flushed on Stage 7 branch mispredictions and JALR jumps
EX1_EX2 | flush | pipeline_control_unit (flush) | Flushed on Stage 7 branch mispredictions and JALR jumps
EX2_EX3 | flush | pipeline_control_unit (flush) | Flushed on Stage 7 branch mispredictions and JALR jumps
MEM_WB | flush | 1'b0 | Never flushed (writeback stage commits cleanly)

## 15. Branch History Table (BHT)

### 15.1 Module: bht (Branch History Table)

File: rtl/core/4_reg_read/bht.sv

A PC-indexed table of 2-bit saturating counters providing dynamic taken/not-taken branch predictions. The BHT is instantiated within the branch_predictor module. The table is read synchronously in Decode (Stage 3) using D_pc[11:2] and evaluated in Register Read (Stage 4). The table is updated synchronously in Stage 7 (EX3/MEM) once the actual branch outcome is known.

#### Structure

Parameter | Value | Description
BHT_ENTRIES | 1024 | Number of table entries (M9K block RAM inferred)
INDEX_WIDTH | 10 | PC bits [11:2] used as index
Counter width | 2 bits | Saturating counter per entry (Strongly Not-Taken = 2'b00, Weakly Not-Taken = 2'b01, Weakly Taken = 2'b10, Strongly Taken = 2'b11)

#### Port Interface

Port | Direction | Width | Description
clk | input | 1 | System clock
reset | input | 1 | Synchronous reset; initializes all counters to Weakly Not-Taken (2'b01)
read_index | input | 10 | Read index from Stage 3 Decode (D_pc[11:2])
read_enable | input | 1 | Read enable (!stall_frontend)
read_counter_out | output | 2 | Counter output registered to Stage 4 (BRAM_counter_out)
write_index | input | 10 | Write index from Stage 7 EX3/MEM (E3_pc[11:2])
write_enable | input | 1 | Write enable (E3_branch)
write_counter_in | input | 2 | Updated counter value (E3_next_counter)

#### 2-Bit Saturating Counter State Machine

State | Encoding | Prediction | On Taken | On Not-Taken
Strongly Not-Taken | 2'b00 | Not-Taken | Weakly Not-Taken | Strongly Not-Taken (saturate)
Weakly Not-Taken | 2'b01 | Not-Taken | Weakly Taken | Strongly Not-Taken
Weakly Taken | 2'b10 | Taken | Strongly Taken | Weakly Not-Taken
Strongly Taken | 2'b11 | Taken | Strongly Taken (saturate) | Weakly Taken

### 15.3 Branch Predictor State Diagram

The BHT uses standard 2-bit saturating counters. The state transitions are shown below:

stateDiagram-v2 SNT: Strongly Not-Taken (00) WNT: Weakly Not-Taken (01) WT: Weakly Taken (10) ST: Strongly Taken (11) SNT --> WNT : Taken SNT --> SNT : Not-Taken WNT --> WT : Taken WNT --> SNT : Not-Taken WT --> ST : Taken WT --> WNT : Not-Taken ST --> ST : Taken ST --> WT : Not-Taken

#### Prediction Evaluation and Usage (Stage 4 - Register Read)

The synchronous BHT read outputs the counter value BRAM_counter_out in Stage 4 (Register Read) as IDRR_counter_val. The prediction is evaluated combinational: assign IDRR_predict_taken = IDRR_branch && (IDRR_counter_val[1] == 1'b1);. If predicted taken, PC redirection is triggered via: assign stage4_pc_sel = IDRR_predict_taken || IDRR_is_jal;, which loads stage4_pc_target = IDRR_branch_target (pre-computed IDRR_pc + IDRR_immediate) into the PC register.

The updated priority for PC selection in pc_update (Stage 1) is:

1. reset - PC resets to 32'b0
2. pc_sel (branch/jump resolved in Stage 7, or misprediction correction) - PC loads Stage 7 target E3_pc_target
3. stage4_pc_sel (BHT predicts taken or early JAL in Stage 4) - PC loads Stage 4 target IDRR_branch_target
4. stall (hazard detected) - PC holds its current value
5. Default - PC increments by 4 (pc + 4)

Prediction Penalty: Because the BHT prediction is evaluated in Stage 4, redirecting a predicted-taken branch flushes 3 in-flight instructions (in Stage 1, Stage 2, and Stage 3). A correctly predicted taken branch therefore incurs a 3-cycle penalty. A correctly predicted not-taken branch incurs 0 penalty. Branch mispredictions (either predicted taken but actually not-taken, or predicted not-taken but actually taken) are resolved in Stage 7 and incur a 6-cycle penalty.

### 15.2 BHT Timing and Compatibility Notes

- The BHT is mapped to M9K block RAM blocks on the FPGA target, ensuring low logic utilization and meeting target frequency constraints.
- The BHT does not predict jump targets for JALR; JALR is always resolved in Stage 7 and flushes the pipeline. JAL is resolved early in Stage 4.
- The BHT does not store branch target addresses; it only stores taken/not-taken history. The actual target address comes from the combinational PC+imm calculation in Stage 4.
- No BHT index aliasing protection (e.g., tags) is implemented. Different PCs mapping to the same index may interfere. This is an accepted limitation for the area budget.

## 16. Memory System

### 16.1 Module: memory (Memory Interconnect)

File: rtl/core/7_ex3_mem/memory.sv

Address decoder and memory router. Routes memory transactions to either data memory or MMIO based on the most significant bit of the address. (Section numbering updated; content unchanged.)

#### Address Map

Address Range | Target | Description
0x00000000 - 0x7FFFFFFF | Data Memory (BRAM) | address[31] = 0
0x80000000 - 0xFFFFFFFF | MMIO Peripherals | address[31] = 1

The is_mmio signal is registered for one cycle (is_mmio_reg) to align with the synchronous memory read latency. The output mux selects between dmem_read_data and mmio_read_data based on this registered signal.

### 16.2 Module: data_mem (Data Memory)

File: rtl/core/7_ex3_mem/data_mem.sv

16384-entry x 32-bit synchronous data memory using M9K BRAM. Supports byte, halfword, and word accesses with alignment logic. Read data is available one cycle after the address is presented.

#### Memory Parameters

Parameter | Value | Description
MEM_DEPTH | 16384 | Number of 32-bit words (64 KiB)

#### Write Behavior

mem_size | Operation | Alignment
2'b10 | Word write (32-bit) | address[31:2] selects word
2'b01 | Halfword write (16-bit) | address[1] selects upper/lower halfword
2'b00 | Byte write (8-bit) | address[1:0] selects byte lane

#### Read Behavior

The word at address[31:2] is read synchronously. The registered addr_low, size_reg, and unsigned_reg signals are used to extract and sign/zero-extend the appropriate byte or halfword from the read word. Read data is zero when read_active (registered mem_read) is deasserted.

mem_size | mem_unsigned | Operation
2'b10 | x | Word read (32-bit, no extension)
2'b01 | 0 | Halfword read, sign-extended to 32 bits
2'b01 | 1 | Halfword read, zero-extended to 32 bits
2'b00 | 0 | Byte read, sign-extended to 32 bits
2'b00 | 1 | Byte read, zero-extended to 32 bits

#### Read-During-Write (RDW) Bypass & Enable-Gated Write Tracking

To resolve Read-During-Write (RDW) collisions on the same 32-bit memory word within the same clock cycle, data_mem includes internal write tracking registers (write_addr_reg, write_data_reg, write_size_reg, write_addr_low_reg, write_en_reg, read_addr_reg). When write_en_reg is asserted and the previous write word address matches the current read word address (write_addr_reg[31:2] == read_addr_reg[31:2]), combinational forwarding logic overrides the BRAM output word with the active write data.

Dynamic Power Optimization (Enable Gating): Sampling of the write tracking registers is explicitly gated by if (mem_read). Write tracking states are only sampled on clock edges when a valid memory read request is present. This prevents unnecessary flip-flop toggling during non-read cycles, reducing dynamic power dissipation.

## 17. Memory-Mapped I/O (MMIO)

### Module: mmio

File: rtl/core/7_ex3_mem/mmio.sv

Interfaces with FPGA board peripherals: switches, keys (buttons), LEDs, and 7-segment hex displays.

#### MMIO Register Map

Address | R/W | Width | Name | Description
0x80000000 | W | 10 | led_reg | LED output (bits [9:0] of write data)
0x80000004 | W | 24 | hex_reg | 7-segment hex display (bits [23:0] of write data)
0x80000008 | R | 10 | Switches | Switch input (zero-extended to 32 bits)
0x8000000C | R | 2 | Keys | Key/button input (zero-extended to 32 bits)

#### Port Interface

Port | Direction | Width | Description
clk | input | 1 | System clock
reset | input | 1 | Synchronous reset (clears LED and hex registers)
mem_read | input | 1 | MMIO read enable
mem_write | input | 1 | MMIO write enable
address | input | 32 | MMIO address
write_data | input | 32 | Data to write
read_data | output | 32 | Read data (registered, 1-cycle latency)
sw_keys | input | 2 | Physical key inputs
sw_switches | input | 10 | Physical switch inputs
out_leds | output | 10 | LED outputs
out_hex | output | 24 | 7-segment hex display outputs

## 18. Pipeline Register Summary

Register | Location | Stall | Flush Source | Reset Value
pc_update (PC reg) | Stage 1 | Yes (stall_frontend) | N/A (uses pc_sel) | 32'b0
instr_mem (instr_reg, pc_reg) | Stage 2 | Yes (stall_frontend) | Yes (flush) | NOP + flush_reg
IF_ID | Stage 2/3 boundary | Yes (stall_frontend) | Yes (flush) | NOP + PC=0
ID_RR | Stage 3/4 boundary | Yes (stall_frontend) | Yes (flush || stall_frontend) | All zeros
regfile | Stage 4 | No | No | All zeros (initialized)
RR_EX1 | Stage 4/5 boundary | No | Yes (flush) | All zeros
EX1_EX2 | Stage 5/6 boundary | No | Yes (flush) | All zeros
EX2_EX3 | Stage 6/7 boundary | No | Yes (flush) | All zeros
MEM_WB | Stage 7/8 boundary | No | No (1'b0) | All zeros

### 18.2 Pipeline Register Signals Breakdown

The table below summarizes the exact signals registered at each pipeline stage boundary.

Register Module | Stage Boundary | Registered Signals
IF_ID | Stage 2 to 3 | pc_out (32b), instruction_out (32b)
ID_RR | Stage 3 to 4 | pc (32b), instruction (32b), rs1 (5b), rs2 (5b), rd (5b), immediate (32b), uses_rs1 (1b), uses_rs2 (1b), alu_op (4b), alu_src_a (1b), alu_src_b (1b), reg_write (1b), mem_read (1b), mem_write (1b), mem_size (2b), mem_unsigned (1b), wb_sel (2b), branch (1b), jump (1b), branch_type (3b)
RR_EX1 | Stage 4 to 5 | All signals from ID_RR, plus: forward_a_sel (2b), forward_b_sel (2b), branch_target (32b)
EX1_EX2 | Stage 5 to 6 | pc (32b), rd (5b), immediate (32b), alu_op (4b), reg_write (1b), mem_read (1b), mem_write (1b), mem_size (2b), mem_unsigned (1b), wb_sel (2b), branch (1b), jump (1b), branch_type (3b), operand_a (32b), operand_b (32b), rs2_data (32b), branch_target (32b)
EX2_EX3 | Stage 6 to 7 | pc (32b), rd (5b), immediate (32b), reg_write (1b), mem_read (1b), mem_write (1b), mem_size (2b), mem_unsigned (1b), wb_sel (2b), branch (1b), jump (1b), branch_type (3b), alu_result (32b), condition_met (1b), branch_target (32b), rs2_data (32b)
MEM_WB | Stage 7 to 8 | pc (32b), rd (5b), reg_write (1b), wb_sel (2b), alu_result (32b, or PC+4), mem_read_data (32b)

## 19. Control Signal Reference

Signal | Width | Source | Description
stall_frontend | 1 | pipeline_control_unit | Stalls Stages 1-3, flushes ID_RR on load-use hazards
flush | 1 | pipeline_control_unit | Global flush of Stages 1-6 on Stage 7 branch misprediction / JALR (flush = E3_pc_sel)
stage4_pc_sel | 1 | pipeline_control_unit | Early PC redirect selector in Stage 4 for JAL or predicted-taken branches
stage4_flush | 1 | pipeline_control_unit | Flushes transient Stage 2-3 instructions on Stage 4 early redirects
alu_op | 4 | control unit | ALU operation select (alu_package encoding)
alu_src_a | 1 | control unit | 0: rs1 (or forwarded), 1: PC
alu_src_b | 1 | control unit | 0: rs2 (or forwarded), 1: immediate
reg_write | 1 | control unit | Register file write enable
mem_read | 1 | control unit | Data memory read enable
mem_write | 1 | control unit | Data memory write enable
mem_size | 2 | funct3[1:0] | 00=byte, 01=halfword, 10=word
mem_unsigned | 1 | funct3[2] | 0=sign-extend, 1=zero-extend load data
wb_sel | 2 | control unit | 00=ALU result, 01=memory data, 10=PC+4
branch | 1 | control unit | Conditional branch instruction flag
jump | 1 | control unit | Unconditional jump instruction flag
branch_type | 3 | funct3 | Branch condition encoding (BEQ, BNE, BLT, BGE, BLTU, BGEU)
uses_rs1 | 1 | control unit | Instruction requires rs1 value
uses_rs2 | 1 | control unit | Instruction requires rs2 value
forward_a_sel | 2 | forwarding_unit | Forwarding mux select for operand A
forward_b_sel | 2 | forwarding_unit | Forwarding mux select for operand B
pc_sel | 1 | pc_target_calc | 1=redirect PC to target in Stage 7, 0=continue sequential
IDRR_predict_taken | 1 | branch_predictor (Stage 4) | 1=predict taken, 0=predict not-taken (MSB of 2-bit counter)
IDRR_branch_target | 32 | branch_predictor (Stage 4) | Early computed PC+imm target; pipelined to Stage 7 / pc_update
E3_fwd_val | 32 | fwd_sel (Stage 7) | Forwarded execution result (PC+4 or alu_result) to Stage 5 and MEM_WB

## 20. Module Hierarchy

core (top-level) | +-- pc_update [Stage 1: Fetch - PC generation and redirect] | +-- instr_mem [Stage 2: Instruction Memory] | +-- IF_ID [Stage 2/3 Pipeline Register] | +-- decode [Stage 3: Decode] | +-- imm_gen | +-- control | +-- ID_RR [Stage 3/4 Pipeline Register] | +-- regfile [Stage 4: Register Read] | +-- branch_predictor [Stage 4: RR - Branch Target Calculation & Direction Prediction] | +-- bht [Branch History Table (1024-entry 2-bit BRAM)] | +-- forwarding_unit [Hazard Control: Forwarding] | +-- RR_EX1 [Stage 4/5 Pipeline Register (carries branch_target)] | +-- data_sel [Stage 5: EX1 - Operand Selection] | +-- EX1_EX2 [Stage 5/6 Pipeline Register (carries branch_target)] | +-- alu [Stage 6: EX2 - ALU] | +-- branch_eval [Stage 6: EX2 - Branch Condition Evaluation only] | +-- EX2_EX3 [Stage 6/7 Pipeline Register (carries branch_target)] | +-- pc_target_calc [Stage 7: EX3 - PC Target Finalization and BHT update trigger] | +-- fwd_sel [Stage 7: EX3 - Forwarding Selector & Pre-Writeback Mux] | +-- memory [Stage 7: EX3 - Memory System] | +-- data_mem | +-- mmio | +-- MEM_WB [Stage 7/8 Pipeline Register] | +-- writeback [Stage 8: WB - Writeback Mux] | +-- pipeline_control_unit [Hazard Control: Stall & Flush Generation]

### 20.1 Module Dependency Graph

The flowchart below displays the instantiation tree and control links between modules inside the core top-level.

graph TD core --> pc_update core --> instr_mem core --> IF_ID core --> decode decode --> imm_gen decode --> control core --> ID_RR core --> regfile core --> branch_predictor branch_predictor --> bht core --> forwarding_unit core --> RR_EX1 core --> data_sel core --> EX1_EX2 core --> alu core --> branch_eval core --> EX2_EX3 core --> pc_target_calc core --> fwd_sel core --> memory memory --> data_mem memory --> mmio core --> MEM_WB core --> writeback core --> pipeline_control_unit

## 21. Timing and Performance

### 21.1 Critical Path Candidates

- ALU path: EX1_EX2 register outputs through ALU combinational logic to EX2_EX3 register inputs (Stage 6). Stage 6 no longer contains the branch-target adder, reducing its combinational depth slightly.
- Branch target path (Stage 4): ID_RR register outputs through the combinational adder to RR_EX1 inputs. This path is added in Stage 4; the addition (32-bit ripple or fast-carry) must complete within the Stage 4 clock period.
- Forwarding path: Forwarding unit combinational logic through RR_EX1 setup time (Stage 4).
- Hazard detection path: Decode combinational outputs through hazard detection unit to stall_frontend and back to IF_ID/ID_RR/pc_update (Stage 3).
- Memory path: Data memory read through alignment and sign-extension logic (Stage 7 to Stage 8).
- Branch resolution path: pc_target_calc combinational logic feeding back to pc_update (Stage 7 to Stage 1).
- BHT prediction path: BHT synchronous read data output in Stage 4 to pc_update input (Stage 1). Since BHT is read synchronously, the read output (BRAM counter value) is available in Stage 4 and is used to compute the prediction combinational in Stage 4. This prediction path feeds back to the Stage 1 PC update register combinational, which is a cross-stage path that must complete within the Stage 4 clock period.

### 21.2 Performance Characteristics

Metric | Value | Notes
Pipeline depth | 8 stages | Deeper than classic 5-stage for better Fmax
Branch penalty (taken, BHT correct) | 3 cycles | Stages 1-3 flushed; target from Stage 4 used
Branch penalty (taken, BHT misprediction) | 6 cycles | Full flush; Stages 1-6 cleared
Branch penalty (not-taken, BHT correct) | 0 cycles | No redirect needed
Branch penalty (not-taken, BHT misprediction) | 6 cycles | Full flush; Stages 1-6 cleared
Jump penalty (JAL) | 3 cycles | Resolved early in Stage 4
Jump penalty (JALR) | 6 cycles | Resolved in Stage 7
Load-use stall (worst case) | Up to 2 cycles | Stalls only when load is in RR or EX1
ALU-to-ALU forwarding | 0 stall cycles | When producer is 2+ stages ahead
IPC (ideal, no hazards) | 1.0 | Single-issue, in-order

### 21.3 Stall Cycle Breakdown

Hazard Scenario | Stall Cycles | Reason
ALU-to-ALU (adjacent): producer in RR (Stage 4), consumer in D (Stage 3) | 0 | No stall; forwarded from EX2 (Stage 6) to EX1 (Stage 5)
ALU-to-ALU (1-instruction gap): producer in EX1 (Stage 5), consumer in D (Stage 3) | 0 | No stall; forwarded from EX3 (Stage 7) to EX1 (Stage 5)
Load-use (adjacent): load in RR (Stage 4), consumer in D (Stage 3) | 2 | Stalls for 2 cycles until load reaches Stage 6/7; forwarded from WB to EX1
Load-use (1-instruction gap): load in EX1 (Stage 5), consumer in D (Stage 3) | 1 | Stalls for 1 cycle until load reaches Stage 6/7; forwarded from WB to EX1
Load-use (2-instruction gap): load in EX2 (Stage 6), consumer in D (Stage 3) | 0 | No stall; forwarded from WB (Stage 8) to EX1 (Stage 5)
Load-use (3-instruction gap): load in EX3 (Stage 7), consumer in D (Stage 3) | 0 | No stall; bypassed via regfile read-during-write in Stage 4

### 21.4 Pipeline Stage Boundary Registers

Post-synthesis static timing analysis measures setup-path propagation delays between the following pipeline register boundaries. Each stage is defined by a source register (output flip-flops of the preceding stage) and a destination register (input flip-flops of the current stage). The register instance names used for timing boundary identification are listed below.

Stage | Stage Name | Source Register | Destination Register
Stage 1 | Fetch Logic | (any; worst path from any register) | stage2_imem address register
Stage 2 | I-Mem Read | stage2_imem address register | stage3_if_id_reg instruction output
Stage 3 | Decode & Hazard | stage3_if_id_reg instruction output | stage3_id_rr_reg outputs
Stage 4 | Register Read | stage3_id_rr_reg outputs | stage4_rr_ex1_reg outputs
Stage 5 | EX1 (Op Sel) | stage4_rr_ex1_reg outputs | stage5_ex1_ex2_reg outputs
Stage 6 | EX2 (ALU) | stage5_ex1_ex2_reg outputs | stage6_ex2_ex3_reg outputs
Stage 7 | EX3 & MEM Addr | stage6_ex2_ex3_reg outputs | stage7_mem_wb_reg outputs
Stage 8 | WB Logic | stage7_mem_wb_reg outputs | stage4_regfile write port

Stage 8 write-back path: The WB stage destination is the register file write port (stage4_regfile), which is physically co-located in Stage 4. This is the cross-stage write-back path also documented in the Forwarding and Module Hierarchy sections.

Stage 1 source: Stage 1 (Fetch Logic) is measured from the worst-case setup path originating anywhere in the design. This includes the long-distance branch resolution feedback path from Stage 7 (pc_target_calc) back to the Stage 1 PC register, as well as the sequential PC+4 increment path.

### 21.5 Physical Synthesis and Timing Verification

Physical synthesis timing analysis (including maximum clock frequency $F_{\text{max}}$, setup/hold slack, and exact stage-by-stage physical propagation delays) is dependent on the target FPGA family, placement constraints, and place-and-route optimization seeds.

These physical synthesis measurements and critical path evaluations are detailed in the Technical Report under Section 1: Physical Synthesis & Power Metrics and Section 2: Timing & Critical Path Analysis.

## 22. Corner Cases and Assumptions

### 22.1 Assumptions

- All instructions are 32-bit aligned (PC[1:0] is always 00).
- Instruction memory is word-addressed using pc[31:2]; byte addressing within instruction words is not supported.
- No exceptions, interrupts, or traps are implemented.
- No CSR (Control and Status Register) instructions are supported.
- No FENCE, ECALL, or EBREAK instructions are implemented.
- The M extension (multiply/divide) is not implemented.
- The A extension (atomics) is not implemented.
- Memory accesses are assumed to complete in 1 cycle (no cache misses, no wait states).
- MMIO reads and writes are registered (1-cycle latency).
- Program memory is loaded at synthesis time via $readmemh("program.hex").

### 22.2 Known Corner Cases

- Register x0 handling: The register file suppresses writes to x0 and the hazard/forwarding units check for rd != 5'b0 and rsN != 5'b0 to avoid false dependencies on x0.
- Simultaneous stall and flush: The pc_sel (flush) has higher priority than stall in pc_update. If a branch resolves while the frontend is stalled, the branch redirect takes precedence and the stalled instruction is discarded.
- Memory read data alignment: W_mem_read_data is registered through the MEM_WB pipeline register (from W_mem_read_data_raw), aligning it perfectly with the other registered writeback signals (such as W_alu_result) for Stage 8 writeback selection.
- NOP encoding: 32'h00000013 is ADDI x0, x0, 0, which is the standard RISC-V NOP. It writes to x0 (no effect), reads x0 (always zero), and adds zero. reg_write will be asserted for this instruction, but the register file suppresses the write to x0.
- JALR alignment: pc_target_calc applies & 32'hFFFFFFFC to both jump and branch targets, clearing the lowest 2 bits to enforce 4-byte alignment. For JAL, the immediate is always 2-byte aligned by construction, so the mask clears at most bit 1. For JALR, the mask is required by the RISC-V specification to clear bit 0 of the computed target (rs1 + imm).

### 22.3 Branch Target and BHT Corner Cases

- JAL early resolution: JAL is resolved in Stage 4 (RR) and its target redirects the PC, flushing Stages 2-3. When JAL reaches Stage 7, its jump control is filtered to prevent double redirection, while JALR still redirects normally in Stage 7.
- JALR branch target: The early branch target calculation in Stage 4 only covers PC-relative targets (B-type, JAL). JALR targets require rs1 which is not available until Stage 5 (after forwarding). The JALR target is still computed by the ALU in Stage 6 and JALR is resolved in Stage 7, incurring a 6-cycle flush penalty.
- BHT index aliasing: Two branch instructions whose PCs alias to the same BHT index may corrupt each other's counter state. No tag bits are stored. This is a known limitation.
- Simultaneous BHT update and read: If the update index (from Stage 7) aliases the read index (from Stage 3) in the same cycle, the write takes priority on the following cycle. The current read returns the old counter value.
- Branch instruction in stall: When stall_frontend is asserted, the Decode PC holds and the BHT lookup is re-presented with the same PC on successive cycles. No spurious update occurs because BHT update is gated by E3_branch, which is independent of the stall signal.
- Reset state: All BHT counters reset to Weakly Not-Taken (2'b01), providing a conservative not-taken default consistent with the prior predict-not-taken baseline.

### 22.4 Top-Level Core Ports

Port | Direction | Width | Description
clk | input | 1 | System clock
reset | input | 1 | Synchronous reset
mmio_keys | input | 2 | FPGA key/button inputs
mmio_switches | input | 10 | FPGA switch inputs
mmio_leds | output | 10 | LED outputs
mmio_hex | output | 24 | 7-segment hex display outputs
out_pc | output | 32 | Writeback-stage PC (debug)
out_writeback_data | output | 32 | Writeback data (debug)
out_reg_write | output | 1 | Register write enable (debug)
out_alu_result | output | 32 | EX2 ALU result (debug)

## 23. Glossary of FPGA Terminology

The following glossary defines core hardware and FPGA concepts referenced throughout this specification:

- BRAM (Block RAM): Dedicated, dual-port static memory arrays embedded directly inside the FPGA silicon (such as Intel's M9K blocks). Unlike logic-cell registers, BRAM provides highly efficient single-cycle read and write access, allowing implementation of large memory blocks (Instruction/Data Memory, Register File, and Branch History Table) without depleting the FPGA's general logic cells.
- Logic Element (LE): The standard unit of logic in Intel FPGAs. A logic element contains a Look-Up Table (LUT) to implement combinational logic gates, a programmable register (D flip-flop) to store data, and dedicated carry chains for fast additions.
- Fmax (Maximum Frequency): The maximum speed at which a digital design can run on the target FPGA without setup timing violations. In this CPU design, operating frequency is set to 125.00 MHz by splitting logic into 8 balanced pipeline stages.
- STA (Static Timing Analysis): A method of analyzing and checking the timing of a digital circuit by computing propagation delays along all logic paths, verifying that setup and hold times are satisfied under worst-case temperature and voltage parameters.
- SDC (Synopsys Design Constraints): A configuration file defining timing requirements, clock constraints, input/output delays, and multi-cycle paths to guide the synthesizer and place-and-route tools during FPGA compilation.
- JTAG (Joint Test Action Group): A standard interface and protocol used to program, test, and debug hardware devices. On the DE10-Lite board, JTAG is used by the USB-Blaster cable to upload compiled bitstreams.
- MMIO (Memory-Mapped Input/Output): A hardware design style where external peripherals (LEDs, switches, hex displays) are assigned specific memory addresses, allowing soft program execution to perform reading or writing operations on hardware using standard load and store instructions.
- BHT (Branch History Table): A dynamic branch prediction buffer containing 2-bit saturating counters indexed by instruction PC bits. It dynamically updates prediction directions (Taken/Not-Taken) based on execution outcomes.
- Setup Slack: The timing margin between the clock period and the longest signal propagation time (data path delay) to a register input. A positive slack indicates that the design safely meets the timing requirements; negative slack means timing is violated.
- Place & Route (Fitting): The compilation phase where Quartus maps logical gates to physical Logic Elements on the chip and sets physical wire routing paths between them.

Architecture Specification - 8-Stage Pipelined RISC-V (RV32I) CPU
Generated from RTL inspection. All signal names and behaviors reflect the current implementation.
