rachitpatel019/riscv-cpu/8_stage_pipeline/tb/tb_control.sv

`timescale 1ns / 1ps

module tb_control;
int tests_total;
int tests_passed;
int tests_failed;
logic watchdog_trigger;

logic [31:0] instruction;
logic uses_rs1;
logic uses_rs2;
logic [3:0] alu_op;
logic alu_src_a;
logic alu_src_b;
logic reg_write;
logic mem_read;
logic mem_write;
logic [1:0] mem_size;
logic mem_unsigned;
logic [1:0] wb_sel;
logic branch;
logic jump;
logic [2:0] branch_type;

control dut (.*);

import alu_package::*;

task automatic report_info(string id, string msg);
    $display("[UVM_INFO]  %s @ %0t: %s", id, $time, msg);
endtask

task automatic report_error(string id, string msg);
    $display("[UVM_ERROR] %s @ %0t: %s", id, $time, msg);
    tests_failed++;
    tests_total++;
endtask

task automatic report_fatal(string id, string msg);
    $display("[UVM_FATAL] %s @ %0t: %s", id, $time, msg);
    $finish;
endtask

task automatic drive(input logic [31:0] i_instr);
    instruction = i_instr;
    #1;
endtask

task automatic check(
    input logic i_uses_rs1, input logic i_uses_rs2, input logic [3:0] i_alu_op,
    input logic i_alu_src_a, input logic i_alu_src_b,
    input logic i_reg_write, input logic i_mem_read, input logic i_mem_write,
    input logic [1:0] i_mem_size, input logic i_mem_unsigned,
    input logic [1:0] i_wb_sel, input logic i_branch, input logic i_jump,
    input logic [2:0] i_branch_type
);
    a_control: assert (uses_rs1 === i_uses_rs1 && uses_rs2 === i_uses_rs2 && alu_op === i_alu_op && 
        alu_src_a === i_alu_src_a && alu_src_b === i_alu_src_b &&
        reg_write === i_reg_write && mem_read === i_mem_read && mem_write === i_mem_write &&
        mem_size === i_mem_size && mem_unsigned === i_mem_unsigned &&
        wb_sel === i_wb_sel && branch === i_branch && jump === i_jump &&
        branch_type === i_branch_type) begin
        tests_passed++;
        tests_total++;
    end else begin
        report_error("CHECK", $sformatf("MISMATCH: Instr=%h, Actual: uses_rs1=%b, uses_rs2=%b, alu_op=%b, alu_src_a=%b, alu_src_b=%b, reg_write=%b, mem_read=%b, mem_write=%b, mem_size=%b, mem_unsigned=%b, wb_sel=%b, branch=%b, jump=%b, branch_type=%b", 
            instruction, uses_rs1, uses_rs2, alu_op, alu_src_a, alu_src_b, reg_write, mem_read, mem_write, mem_size, mem_unsigned, wb_sel, branch, jump, branch_type));
    end
endtask

initial begin
    watchdog_trigger = 0;
    fork
        begin
            #100_000;
            report_fatal("WATCHDOG", "Simulation timed out.");
        end
        begin
            wait (watchdog_trigger);
        end
    join_any
    disable fork;
    $finish;
end

initial begin
    tests_total = 0;
    tests_passed = 0;
    tests_failed = 0;
    report_info("TB", "Starting control tests.");

    drive(32'h002081b3); check(1, 1, ALU_ADD, 0, 0, 1, 0, 0, 2'b00, 0, 2'b00, 0, 0, 3'b000);
    drive(32'h00a00093); check(1, 0, ALU_ADD, 0, 1, 1, 0, 0, 2'b00, 0, 2'b00, 0, 0, 3'b000);
    drive(32'h00412083); check(1, 0, ALU_ADD, 0, 1, 1, 1, 0, 2'b10, 0, 2'b01, 0, 0, 3'b010);
    drive(32'h0020a223); check(1, 1, ALU_ADD, 0, 1, 0, 0, 1, 2'b10, 0, 2'b00, 0, 0, 3'b010);
    drive(32'h00208463); check(1, 1, ALU_PASS, 0, 0, 0, 0, 0, 2'b00, 0, 2'b00, 1, 0, 3'b000);
    drive(32'h004000ef); check(0, 0, ALU_ADD, 1, 1, 1, 0, 0, 2'b00, 0, 2'b10, 0, 1, 3'b000);
    drive(32'h010000b7); check(0, 0, ALU_PASS, 0, 1, 1, 0, 0, 2'b00, 0, 2'b00, 0, 0, 3'b000);
    drive(32'h01000097); check(0, 0, ALU_ADD, 1, 1, 1, 0, 0, 2'b00, 0, 2'b00, 0, 0, 3'b000);
    drive(32'h00000000); check(0, 0, ALU_PASS, 0, 0, 0, 0, 0, 2'b00, 0, 2'b00, 0, 0, 3'b000);

    // Drive LBU instruction to toggle mem_unsigned to 1 for 100% net coverage
    drive(32'h00414083); check(1, 0, ALU_ADD, 0, 1, 1, 1, 0, 2'b00, 1, 2'b01, 0, 0, 3'b100);

    report_info("TB", "All tests complete.");
    $display("--- control Test Summary ---");
    $display("Total: %0d | Passed: %0d | Failed: %0d", tests_total, tests_passed, tests_failed);
    if (tests_failed == 0) begin
        $display("RESULT: PASS");
    end else begin
        $display("RESULT: FAIL");
    end
    watchdog_trigger = 1;
end
endmodule
