rachitpatel019/riscv-cpu/8_stage_pipeline/rtl/core/7_ex3_mem/data_mem.sv

/*
Data memory module supporting byte, halfword, and word accesses.
Provides alignment logic and infers M9K BRAM blocks as a Simple Dual-Port RAM.
*/

module data_mem (
    input logic clk,

    input logic mem_read,
    input logic [31:0] read_address,
    input logic [1:0] read_mem_size,

    input logic mem_write,
    input logic [31:0] write_address,
    input logic [31:0] write_data,
    input logic [1:0] write_mem_size,

    input logic mem_unsigned,

    output logic [31:0] read_data
);

localparam MEM_DEPTH = 16384;

// Storage memory array inferred as Altera/Intel M9K Block RAM.
(* ramstyle = "M9K" *) logic [31:0] memory [0:MEM_DEPTH-1] = '{default: 32'b0};

// Internal read data and pipeline registers.
logic [31:0] current_word;
logic [31:0] shifted_word;
logic [1:0] addr_low;

logic read_active;
logic [1:0] size_reg;
logic unsigned_reg;

// Pipelined write state registers for Read-During-Write hazard detection.
logic [31:0] write_addr_reg;
logic [31:0] write_data_reg;
logic [1:0] write_size_reg;
logic [1:0] write_addr_low_reg;
logic write_en_reg;
logic [31:0] read_addr_reg;

logic [31:0] forwarded_word;

// Synchronous write port logic handling byte, halfword, and word masking.
always_ff @(posedge clk) begin
    if (mem_write) begin
        case (write_mem_size)
            2'b10: memory[write_address[31:2]] <= write_data;
            2'b01:
                case (write_address[1])
                    1'b1: memory[write_address[31:2]][31:16] <= write_data[15:0];
                    1'b0: memory[write_address[31:2]][15:0] <= write_data[15:0];
                endcase
            2'b00:
                case (write_address[1:0])
                    2'b11: memory[write_address[31:2]][31:24] <= write_data[7:0];
                    2'b10: memory[write_address[31:2]][23:16] <= write_data[7:0];
                    2'b01: memory[write_address[31:2]][15:8] <= write_data[7:0];
                    2'b00: memory[write_address[31:2]][7:0] <= write_data[7:0];
                endcase
            default: memory[write_address[31:2]] <= write_data;
        endcase
    end
end

// Synchronous read port storing read data and memory control state.
always_ff @(posedge clk) begin
    if (mem_read) begin
        current_word <= memory[read_address[31:2]];
        addr_low <= read_address[1:0];
        size_reg <= read_mem_size;
        unsigned_reg <= mem_unsigned;
    end
    read_active <= mem_read;
end

// Write tracking registers to sample write control signals on clock edge.
always_ff @(posedge clk) begin
    if (mem_read) begin
        write_addr_reg     <= write_address;
        write_data_reg     <= write_data;
        write_size_reg     <= write_mem_size;
        write_addr_low_reg <= write_address[1:0];
        write_en_reg       <= mem_write;
        read_addr_reg      <= read_address;
    end
end

// Write-during-read bypass and forwarding logic to resolve RDW collisions on same word.
always_comb begin
    forwarded_word = current_word;
    if (write_en_reg && (write_addr_reg[31:2] == read_addr_reg[31:2])) begin
        case (write_size_reg)
            2'b10: forwarded_word = write_data_reg;
            2'b01:
                case (write_addr_low_reg[1])
                    1'b1: forwarded_word = {write_data_reg[15:0], current_word[15:0]};
                    1'b0: forwarded_word = {current_word[31:16], write_data_reg[15:0]};
                endcase
            2'b00:
                case (write_addr_low_reg[1:0])
                    2'b11: forwarded_word = {write_data_reg[7:0], current_word[23:0]};
                    2'b10: forwarded_word = {current_word[31:24], write_data_reg[7:0], current_word[15:0]};
                    2'b01: forwarded_word = {current_word[31:16], write_data_reg[7:0], current_word[7:0]};
                    2'b00: forwarded_word = {current_word[31:8], write_data_reg[7:0]};
                endcase
            default: forwarded_word = write_data_reg;
        endcase
    end
end

// Asynchronous byte/halfword alignment shifter based on byte offset.
assign shifted_word = forwarded_word >> {addr_low, 3'b000};

// Formatting and sign/zero extension logic for final read output data.
always_comb begin
    if (read_active) begin
        case (size_reg)
            2'b10: read_data = forwarded_word;
            2'b01:
                if (unsigned_reg)
                    read_data = {16'b0, shifted_word[15:0]};
                else
                    read_data = {{16{shifted_word[15]}}, shifted_word[15:0]}; 
            2'b00:
                if (unsigned_reg)
                    read_data = {24'b0, shifted_word[7:0]};
                else
                    read_data = {{24{shifted_word[7]}}, shifted_word[7:0]}; 
            default: read_data = forwarded_word;
        endcase
    end
    else begin
        read_data = 32'b0;
    end
end

endmodule
