rachitpatel019/riscv-cpu/8_stage_pipeline/tb/tb_data_mem.sv

`timescale 1ns / 1ps

module tb_data_mem;
int tests_total;
int tests_passed;
int tests_failed;
logic watchdog_trigger;

localparam CLK_PERIOD = 10;

logic clk;
logic mem_read;
logic mem_write;
logic [31:0] address;
logic [31:0] write_data;
logic [1:0] mem_size;
logic mem_unsigned;

logic [31:0] read_data;

// Instantiates the data memory under test.
data_mem dut (
    .clk(clk),
    .mem_read(mem_read),
    .read_address(address),
    .read_mem_size(mem_size),
    .mem_write(mem_write),
    .write_address(address),
    .write_data(write_data),
    .write_mem_size(mem_size),
    .mem_unsigned(mem_unsigned),
    .read_data(read_data)
);

// Generates clock pulses.
always #(CLK_PERIOD / 2) clk = ~clk;

// Prints informational simulation messages.
task automatic report_info(string id, string msg);
    $display("[UVM_INFO]  %s @ %0t: %s", id, $time, msg);
endtask

// Prints simulation error messages and increments failure count.
task automatic report_error(string id, string msg);
    $display("[UVM_ERROR] %s @ %0t: %s", id, $time, msg);
    tests_failed++;
    tests_total++;
endtask

// Prints simulation fatal messages and terminates execution.
task automatic report_fatal(string id, string msg);
    $display("[UVM_FATAL] %s @ %0t: %s", id, $time, msg);
    $finish;
endtask

// Drives control and address/data inputs on clock falling edge.
task automatic drive(
    input logic i_read,
    input logic i_write,
    input logic [31:0] i_addr,
    input logic [31:0] i_wdata,
    input logic [1:0] i_size,
    input logic i_uns
);
    @(negedge clk);
    mem_read = i_read;
    mem_write = i_write;
    address = i_addr;
    write_data = i_wdata;
    mem_size = i_size;
    mem_unsigned = i_uns;
endtask

// Checks memory read output against expected data on clock rising edge.
task automatic check(input logic [31:0] exp_data);
    @(posedge clk);
    #1;
    a_data_mem_read: assert (read_data === exp_data) begin
        tests_passed++;
        tests_total++;
    end else begin
        report_error("CHECK", $sformatf("MISMATCH: Addr=%h, Size=%b, Unsigned=%b, Exp=%h, Act=%h", 
            address, mem_size, mem_unsigned, exp_data, read_data));
    end
endtask

// Watchdog timer block to abort simulation in case of hangs.
initial begin
    watchdog_trigger = 0;
    fork
        begin
            #100_000;
            report_fatal("WATCHDOG", "Simulation timed out.");
        end
        begin
            wait (watchdog_trigger);
        end
    join_any
    disable fork;
    $finish;
end

// Main stimulus block applying test cases.
initial begin
    clk = 0;
    tests_total = 0;
    tests_passed = 0;
    tests_failed = 0;
    mem_read = 0;
    mem_write = 0;
    report_info("TB", "Starting data_mem tests.");

    // Original unmodified test cases
    drive(0, 1, 32'h0, 32'hDEADBEEF, 2'b10, 0); 
    drive(1, 0, 32'h0, 0, 2'b10, 0);           
    check(32'hDEADBEEF);

    drive(1, 0, 32'h0, 0, 2'b01, 1);           
    check(32'hBEEF);
    drive(1, 0, 32'h2, 0, 2'b01, 1);           
    check(32'hDEAD);

    drive(1, 0, 32'h0, 0, 2'b00, 1);           
    check(32'hEF);
    drive(1, 0, 32'h1, 0, 2'b00, 1);           
    check(32'hBE);

    drive(0, 1, 32'h4, 32'h00000080, 2'b10, 0); 
    drive(1, 0, 32'h4, 0, 2'b00, 0);           
    check(32'hFFFFFF80);

    // New additional test cases to improve byte and halfword coverage
    drive(0, 1, 32'h8, 32'h12345678, 2'b10, 0); 

    drive(1, 0, 32'h8, 0, 2'b00, 1);           
    check(32'h78);

    drive(1, 0, 32'h9, 0, 2'b00, 1);           
    check(32'h56);

    drive(1, 0, 32'ha, 0, 2'b00, 1);           
    check(32'h34);

    drive(1, 0, 32'hb, 0, 2'b00, 1);           
    check(32'h12);

    drive(1, 0, 32'h8, 0, 2'b00, 0);           
    check(32'h78);

    drive(0, 1, 32'hc, 32'h8899aabb, 2'b10, 0); 

    drive(1, 0, 32'hc, 0, 2'b00, 0);           
    check(32'hffffffbb);

    drive(1, 0, 32'hd, 0, 2'b00, 0);           
    check(32'hffffffaa);

    drive(1, 0, 32'he, 0, 2'b00, 0);           
    check(32'hffffff99);

    drive(1, 0, 32'hf, 0, 2'b00, 0);           
    check(32'hffffff88);

    drive(1, 0, 32'hc, 0, 2'b01, 0);           
    check(32'hffffaabb);

    drive(1, 0, 32'he, 0, 2'b01, 0);           
    check(32'hffff8899);

    // Test write-during-read bypass / forwarding logic (collisions)
    drive(1, 1, 32'h10, 32'h11223344, 2'b10, 0); 
    check(32'h11223344);

    drive(1, 1, 32'h10, 32'h0000aab0, 2'b01, 0); 
    check(32'hffffaab0);

    drive(1, 1, 32'h12, 32'hccdd0000, 2'b01, 0); 
    check(32'h00000000);

    drive(1, 1, 32'h10, 32'h00000055, 2'b00, 0); 
    check(32'h00000055);

    drive(1, 1, 32'h11, 32'h00000066, 2'b00, 0); 
    check(32'h00000066);

    drive(1, 1, 32'h12, 32'h00000077, 2'b00, 0); 
    check(32'h00000077);

    drive(1, 1, 32'h13, 32'h00000088, 2'b00, 0); 
    check(32'hffffff88);

    // Turn off read/write and verify read inactive (yields 0)
    drive(0, 0, 32'h10, 0, 2'b10, 0);           
    check(32'b0);

    report_info("TB", "All tests complete.");
    $display("--- data_mem Test Summary ---");
    $display("Total: %0d | Passed: %0d | Failed: %0d", tests_total, tests_passed, tests_failed);
    if (tests_failed == 0) begin
        $display("RESULT: PASS");
    end else begin
        $display("RESULT: FAIL");
    end
    watchdog_trigger = 1;
end

endmodule
