rachitpatel019/riscv-cpu/8_stage_pipeline/rtl/core/4_reg_read/RR_EX1.sv

/*
Pipeline register between Reg Read and EX1 stages.
Holds data signals, control signals, and forwarding select lines.
*/

module RR_EX1 (
    input logic clk,
    input logic reset,
    input logic flush,

    input logic [31:0] immediate_in,
    input logic [4:0] rs1_in,
    input logic [4:0] rs2_in,
    input logic [4:0] rd_in,
    input logic [31:0] pc_in,

    input logic uses_rs1_in,
    input logic uses_rs2_in,
    input logic [3:0] alu_op_in,
    input logic alu_src_a_in,
    input logic alu_src_b_in,
    input logic reg_write_in,
    input logic mem_read_in,
    input logic mem_write_in,
    input logic [1:0] mem_size_in,
    input logic mem_unsigned_in,
    input logic [1:0] wb_sel_in,
    input logic branch_in,
    input logic jump_in,
    input logic [2:0] branch_type_in,
    input logic predicted_taken_in,
    input logic [1:0] forward_a_sel_in,
    input logic [1:0] forward_b_sel_in,
    input logic [31:0] branch_target_in,
    input logic [1:0] counter_val_in,

    output logic [31:0] immediate_out,
    output logic [4:0] rs1_out,
    output logic [4:0] rs2_out,
    output logic [4:0] rd_out,
    output logic [31:0] pc_out,

    output logic uses_rs1_out,
    output logic uses_rs2_out,
    output logic [3:0] alu_op_out,
    output logic alu_src_a_out,
    output logic alu_src_b_out,
    output logic reg_write_out,
    output logic mem_read_out,
    output logic mem_write_out,
    output logic [1:0] mem_size_out,
    output logic mem_unsigned_out,
    output logic [1:0] wb_sel_out,
    output logic branch_out,
    output logic jump_out,
    output logic [2:0] branch_type_out,
    output logic predicted_taken_out,
    output logic [1:0] forward_a_sel_out,
    output logic [1:0] forward_b_sel_out,
    output logic [31:0] branch_target_out,
    output logic [1:0] counter_val_out
);

// Propagates Reg Read stage values to execution Stage 5 (EX1), supporting flush and reset.
always_ff @(posedge clk) begin
    if (reset || flush) begin
        immediate_out <= 32'b0;
        rs1_out <= 5'b0;
        rs2_out <= 5'b0;
        rd_out <= 5'b0;
        pc_out <= 32'b0;

        uses_rs1_out <= 1'b0;
        uses_rs2_out <= 1'b0;
        alu_op_out <= 4'b0;
        alu_src_a_out <= 1'b0;
        alu_src_b_out <= 1'b0;
        reg_write_out <= 1'b0;
        mem_read_out <= 1'b0;
        mem_write_out <= 1'b0;
        mem_size_out <= 2'b0;
        mem_unsigned_out <= 1'b0;
        wb_sel_out <= 2'b0;
        branch_out <= 1'b0;
        jump_out <= 1'b0;
        branch_type_out <= 3'b0;
        predicted_taken_out <= 1'b0;
        forward_a_sel_out <= 2'b00;
        forward_b_sel_out <= 2'b00;
        branch_target_out <= 32'b0;
        counter_val_out <= 2'b0;
    end
    else begin
        immediate_out <= immediate_in;
        rs1_out <= rs1_in;
        rs2_out <= rs2_in;
        rd_out <= rd_in;
        pc_out <= pc_in;

        uses_rs1_out <= uses_rs1_in;
        uses_rs2_out <= uses_rs2_in;
        alu_op_out <= alu_op_in;
        alu_src_a_out <= alu_src_a_in;
        alu_src_b_out <= alu_src_b_in;
        reg_write_out <= reg_write_in;
        mem_read_out <= mem_read_in;
        mem_write_out <= mem_write_in;
        mem_size_out <= mem_size_in;
        mem_unsigned_out <= mem_unsigned_in;
        wb_sel_out <= wb_sel_in;
        branch_out <= branch_in;
        jump_out <= jump_in;
        branch_type_out <= branch_type_in;
        predicted_taken_out <= predicted_taken_in;
        forward_a_sel_out <= forward_a_sel_in;
        forward_b_sel_out <= forward_b_sel_in;
        branch_target_out <= branch_target_in;
        counter_val_out <= counter_val_in;
    end    
end

endmodule
