rachitpatel019/riscv-cpu/8_stage_pipeline/rtl/core/4_reg_read/regfile.sv

/*
Register file defining 32 32-bit registers.
*/

module regfile (
    input logic clk,

    input logic [4:0] read_address1,
    input logic [4:0] read_address2,
    input logic read_enable_1,
    input logic read_enable_2,

    output logic [31:0] read_data1,
    output logic [31:0] read_data2,

    input logic [4:0] write_address,
    input logic [31:0] write_data,
    input logic write_enable
);

/*
BRAM memory has 2 ports, but the register file must support 2 reads and 1 write
in a single cycle. Replicated memory arrays are configured as BRAM to allow
simultaneous dual-port reads.
*/
(* ramstyle = "M9K" *) logic [31:0] registers_a [31:0] = '{default: 32'b0};
(* ramstyle = "M9K" *) logic [31:0] registers_b [31:0] = '{default: 32'b0};

logic [31:0] write_data_actual;

// Enforces that register 0 remains hardwired to zero as per RISC-V ISA.
assign write_data_actual = (write_address == 5'b0) ? 32'b0 : write_data;

// Synchronously updates both replicated arrays with the write data on the active clock edge.
always_ff @(posedge clk) begin
    if (write_enable && (write_address != 5'b0)) begin
        registers_a[write_address] <= write_data_actual;
        registers_b[write_address] <= write_data_actual;
    end
end

// Reads data from the first memory array, forwarding write data if a read-during-write collision occurs.
always_ff @(posedge clk) begin
    if (read_enable_1) begin
        if (write_enable && (write_address == read_address1) && (write_address != 5'b0)) begin
            read_data1 <= write_data_actual;
        end
        else begin
            read_data1 <= registers_a[read_address1];
        end
    end
end

// Reads data from the second memory array, forwarding write data if a read-during-write collision occurs.
always_ff @(posedge clk) begin
    if (read_enable_2) begin
        if (write_enable && (write_address == read_address2) && (write_address != 5'b0)) begin
            read_data2 <= write_data_actual;
        end
        else begin
            read_data2 <= registers_b[read_address2];
        end
    end
end

endmodule
