rachitpatel019/riscv-cpu/8_stage_pipeline/rtl/core/7_ex3_mem/mmio.sv

/*
Memory-mapped I/O (MMIO) interface module.
Routes accesses to FPGA switches, keys, LEDs, and 7-segment displays.
*/

module mmio (
    input logic clk,
    input logic reset,

    input logic mem_read,
    input logic [31:0] read_address,

    input logic mem_write,
    input logic [31:0] write_address,
    input logic [31:0] write_data,

    output logic [31:0] read_data,

    input logic [1:0] sw_keys,
    input logic [9:0] sw_switches,

    output logic [9:0] out_leds,
    output logic [23:0] out_hex
);

logic [9:0] led_reg;
logic [23:0] hex_reg;

// Maps internal registers to module outputs.
assign out_leds = led_reg;
assign out_hex = hex_reg;

// Synchronous writing to LEDs and 7-segment register spaces using write address bit [2].
always_ff @(posedge clk) begin
    if (reset) begin
        led_reg <= 10'b0;
        hex_reg <= 24'b0;
    end else if (mem_write) begin
        case (write_address[2])
            1'b0: led_reg <= write_data[9:0];  // 32'h80000000
            1'b1: hex_reg <= write_data[23:0]; // 32'h80000004
            default: ;
        endcase
    end
end

// Synchronous reading from switches and keys register spaces using read address bits [3:2].
always_ff @(posedge clk) begin
    if (mem_read) begin
        case (read_address[3:2])
            2'b10:   read_data <= {22'b0, sw_switches}; // 32'h80000008
            2'b11:   read_data <= {30'b0, sw_keys};     // 32'h8000000C
            default: read_data <= 32'b0;
        endcase
    end else begin
        read_data <= 32'b0;
    end
end

endmodule
