rachitpatel019/riscv-cpu/5_stage_pipeline/rtl/1_fetch/fetch.sv

/* Fetch stage of the 5-stage RISC-V pipeline.
Responsible for fetching instructions from memory and updating the program counter (PC).
TODO: Implement control flow handling for branch and jump instructions.
TODO: Output the next program counter value to support branch and jump instructions. */

module fetch(
    input logic clk,
    input logic reset,
    input logic stall,
    input logic pc_sel,
    input logic [31:0] pc_target,

    output logic [31:0] pc,
    output logic [31:0] instruction
);

logic [31:0] next_address;

// Instruction memory is now synchronous.
// It uses !stall as enable to hold the instruction during a stall.
instr_mem imem(
    .clk(clk),
    .en(!stall),
    .pc(pc),
    .instruction(instruction)
);

pc_update pc_upd(
    .current_address(pc),
    .next_address(next_address),
    .stall(stall),
    .pc_sel(pc_sel),
    .pc_target(pc_target)
);

pc pc_reg(
    .clk(clk),
    .reset(reset),
    .next_address(next_address),
    .current_address(pc)
);

endmodule
