rachitpatel019/riscv-cpu/5_stage_pipeline/rtl/3_execute/alu.sv

// Arithmetic Logic Unit

module alu(
    input logic [31:0] A, // operand 1
    input logic [31:0] B, // operand 2
    input logic [3:0] control, // operation
    output logic [31:0] result // result
);

import alu_package::*;

always_comb begin // change output immediately on input change
    // perform operation based on control variable
    case (control)
        ALU_ADD : result = A + B;
        ALU_SUB : result = A + (~B + 1'b1);
        ALU_AND : result = A & B;
        ALU_OR : result = A | B;
        ALU_XOR : result = A ^ B;
        ALU_SLTU : result = {31'b0, A < B}; // UNSIGNED LESS THAN
        ALU_SLT : result = {31'b0, $signed(A) < $signed(B)}; // SIGNED LESS THAN
        ALU_SLL : result = A << B[4:0]; // SHIFT LEFT LOGICAL (only last 5 bits of B are used to evaluate the shift amount)
        ALU_SRL : result = A >> B[4:0]; // SHIFT RIGHT LOGICAL (only last 5 bits of B are used to evaluate the shift amount)
        ALU_SRA : result = $signed(A) >>> B[4:0]; // SHIFT RIGHT ARITHMETIC (only last 5 bits of B are used to evaluate the shift amount)
        ALU_PASS : result = B;
        default : result = 0;
    endcase
end

endmodule
