rachitpatel019/riscv-cpu/5_stage_pipeline/rtl/1_fetch/pc.sv

// Stores the current program counter (PC) value and updates it on each clock cycle.

module pc(
    input logic clk,
    input logic reset,
    input logic [31:0] next_address,
    
    output logic [31:0] current_address
);

always_ff @(posedge clk) begin
    if (reset)
        current_address <= 32'b0;
    else
        current_address <= next_address;
end
    
endmodule
