rachitpatel019/riscv-cpu/(commit log)

2026-03-25 Added files for the fetch stage of the CPU. Added testbench to test the fetch functionality of the CPU
2026-03-27 Added files for the decode stage of the cpu. Added decoder package and updated ALU package.
2026-03-28 Added execute stage file and testbench.
2026-04-01 Added testbench for CPU. Fixed errors in CPU.
    [cpu.sv, cpu_tb.sv]
2026-05-07 Fixed minor bugs. Added program files to git.
    [control.sv, cpu.sv, execute.sv]
2026-05-07 Started 5 stage pipelined design. Added fetch stage logic and testbench. Added IF/ID pipeline register.
2026-05-08 Added decode stage files and ID/EX pipeline register. Added decode testbench. Added Packages.
2026-05-09 Added execute stage files, EX/MEM pipeline register, and execute testbench.
2026-05-11 Added memory and writeback stage files and testbenches. Added MEM/WB pipeline register.
2026-05-13 Enhance 5-stage pipeline: - Updated execute stage to include forwarding signals for ALU operand selection. - Modified memory stage to pass through additional control signals. - Refactored writeback s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
2026-05-13 Implement stall handling and hazard detection in the 5-stage pipeline - Updated pc_update to include stall input for PC calculation. - Enhanced control module to output uses_rs2 for hazard handling. 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
    [ID_EX.sv, IF_ID.sv, control.sv, decode.sv, forwarding_unit.sv, pc_update.sv]
2026-05-15 - Abstracted PC target solution in a separate module. - Added branch resolution unit. - Implemented flushing. - Fixed pipeline register output mismatch bug. - Implemented core module for connecting p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
    [EX_MEM.SV, ID_EX.sv, IF_ID.sv, MEM_WB.sv, core.sv, core_tb.sv, execute.sv, fetch.sv]
2026-05-18 Added missing signals in core.sv
    [EX_MEM.SV, ID_EX.sv, MEM_WB.sv, core.sv, execute.sv]
2026-06-03 Deeper pipeline stages constructed
2026-06-03 Added core.sv and fixed bugs
    [EX1_EX2.sv, EX2_EX3.sv, MEM_WB.sv, core.sv, instr_mem.sv]
2026-06-05 Update hazard control for full 12 stage pipeline
2026-06-05 Minor edge case resolved
    [core.sv, regfile.sv]
2026-06-11 Implemented ALU test program. Fixed JAL vs JALR bug in pc target calculation logic.
    [pc_target_calc.sv]
2026-06-11 Optimized 12 stage pipeline to 8 stages
2026-07-13 Increased instruction and data memory depth to 16384. Refined hazard detection logic by removing unnecessary inputs and adding additional forwarding paths to reduce stall/flush penalties.
    [core.sv, data_mem.sv, hazard_detection_unit.sv, instr_mem.sv]
2026-07-15 Added power analysis script and documentation
2026-07-16 Add testbench for benchmarking and power analysis
2026-07-17 Moved DMEM write to stage 7 and added forwarding paths to resolve the resulting RAW hazard. Modified hazard detection unit to differentiate between ALU and DMEM load stalls
    [core.sv, data_mem.sv, hazard_detection_unit.sv, memory.sv, mmio.sv, tb_benchmark.sv, tb_data_mem.sv]
2026-07-18 Fixed slight naming inconsistency
    [benchmark_diff_test.py, data_mem.sv, instr_mem.sv, memory.sv, tb_benchmark.sv]
2026-08-29 Fixed simulation regression bug
    [tb_alu.sv, tb_bht.sv, tb_branch_eval.sv, tb_control.sv, tb_core.sv, tb_data_mem.sv, tb_data_sel.sv, tb_decode.sv]
2026-09-03 Added enable to dmem read to reduce power
